ddr997/ZgrzewanieCNC/Repetier-Host/Slic3r/var/Slic3r.png

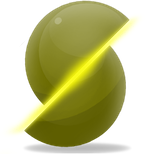
Repetier-Host/Slic3r/var/Slic3r.png
