ddr997/ZgrzewanieCNC/Repetier-Host/Slic3rPE/resources/localization/list.txt

src/slic3r/GUI/AboutDialog.cpp
src/slic3r/GUI/BackgroundSlicingProcess.cpp
src/slic3r/GUI/BedShapeDialog.cpp
src/slic3r/GUI/BedShapeDialog.hpp
src/slic3r/GUI/BonjourDialog.cpp
src/slic3r/GUI/ButtonsDescription.cpp
src/slic3r/GUI/ConfigSnapshotDialog.cpp
src/slic3r/GUI/ConfigWizard.cpp
src/slic3r/GUI/Field.cpp
src/slic3r/GUI/FirmwareDialog.cpp
src/slic3r/GUI/GLCanvas3D.cpp
src/slic3r/GUI/Gizmos/GLGizmoCut.cpp
src/slic3r/GUI/Gizmos/GLGizmoFlatten.cpp
src/slic3r/GUI/Gizmos/GLGizmoMove.cpp
src/slic3r/GUI/Gizmos/GLGizmoRotate.cpp
src/slic3r/GUI/Gizmos/GLGizmoScale.cpp
src/slic3r/GUI/Gizmos/GLGizmoSlaSupports.cpp
src/slic3r/GUI/GUI.cpp
src/slic3r/GUI/GUI_App.cpp
src/slic3r/GUI/GUI_ObjectList.cpp
src/slic3r/GUI/GUI_ObjectManipulation.cpp
src/slic3r/GUI/GUI_ObjectSettings.cpp
src/slic3r/GUI/GUI_Preview.cpp
src/slic3r/GUI/KBShortcutsDialog.cpp
src/slic3r/GUI/MainFrame.cpp
src/slic3r/GUI/MsgDialog.cpp
src/slic3r/GUI/Plater.cpp
src/slic3r/GUI/Preferences.cpp
src/slic3r/GUI/Preset.cpp
src/slic3r/GUI/PresetBundle.cpp
src/slic3r/GUI/PresetHints.cpp
src/slic3r/GUI/PrintHostDialogs.cpp
src/slic3r/GUI/ProgressStatusBar.cpp
src/slic3r/GUI/RammingChart.cpp
src/slic3r/GUI/SysInfoDialog.cpp
src/slic3r/GUI/Tab.cpp
src/slic3r/GUI/Tab.hpp
src/slic3r/GUI/UpdateDialogs.cpp
src/slic3r/GUI/WipeTowerDialog.cpp
src/slic3r/GUI/wxExtensions.cpp
src/slic3r/Utils/Duet.cpp
src/slic3r/Utils/OctoPrint.cpp
src/slic3r/Utils/PresetUpdater.cpp
src/slic3r/Utils/FixModelByWin10.cpp
src/libslic3r/Zipper.cpp
src/libslic3r/SLA/SLASupportTree.cpp
src/libslic3r/Print.cpp
src/libslic3r/SLAPrint.cpp
src/libslic3r/PrintBase.cpp
src/libslic3r/PrintConfig.cpp
src/libslic3r/PrintObject.cpp
src/libslic3r/GCode/PreviewData.cpp
