ddr997/ZgrzewanieCNC/Repetier-Host/data/ArrowX.stl

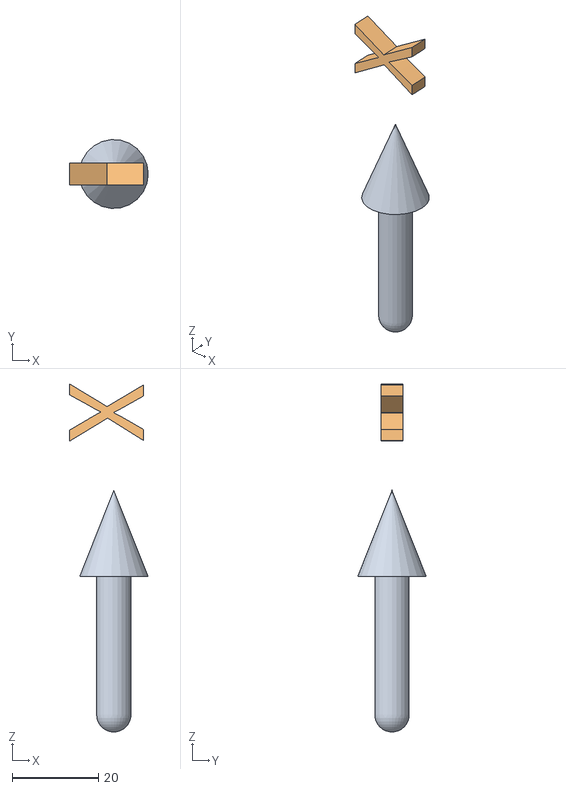
[picture p44: CAD file, 2021-02-12]
Repetier-Host/data/ArrowX.stl
18.2 x 16.0 x 80.7
Additionskörper_527
ACIS-Volumenkörper_1517
