ddr997/ZgrzewanieCNC/Repetier-Host/data/models/DemoPrinter_2.stl

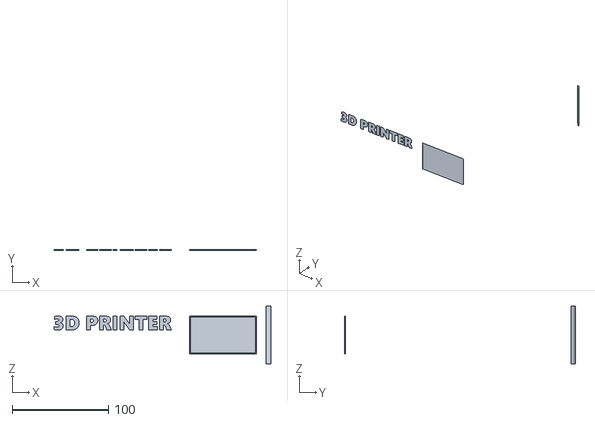
[picture p45: CAD file, 2021-02-12]
Repetier-Host/data/models/DemoPrinter_2.stl
226.0 x 241.0 x 60.0
