ddr997/ZgrzewanieCNC/Repetier-Host/Slic3rPE/resources/models/mk2_bed.stl

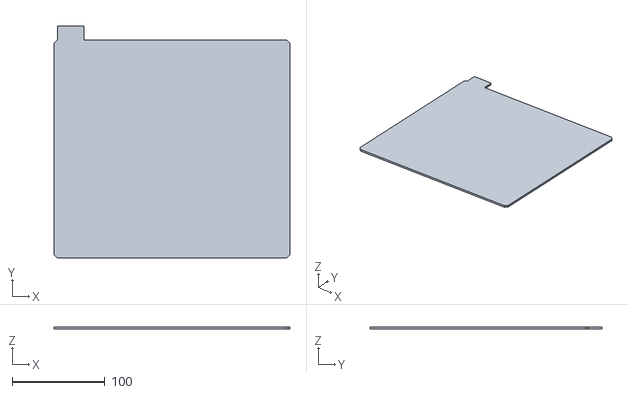
[picture p46: CAD file, 2021-02-12]
Repetier-Host/Slic3rPE/resources/models/mk2_bed.stl
254.0 x 250.0 x 2.50
