ddr997/ZgrzewanieCNC/siłownik_2membrany_plaski.stl

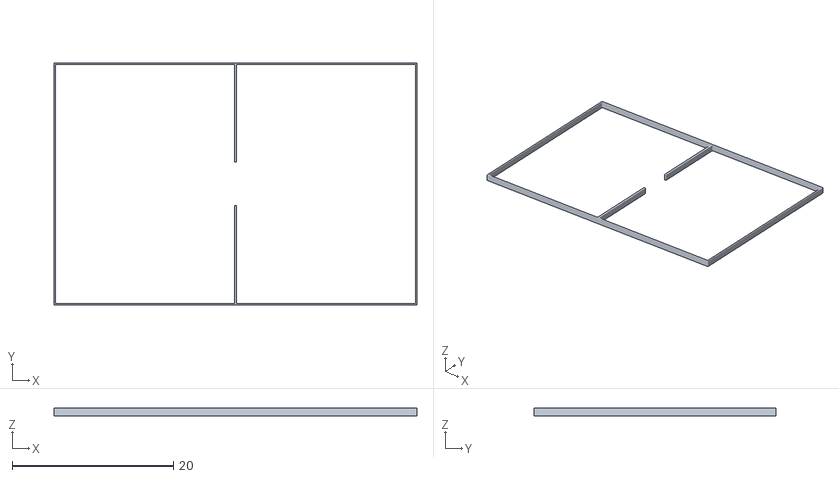
[picture p47: CAD file, 2021-02-12]
siłownik_2membrany_plaski.stl
45.0 x 30.0 x 1.00
