ddr997/ZgrzewanieCNC/Repetier-Host/data/ArrowY.stl

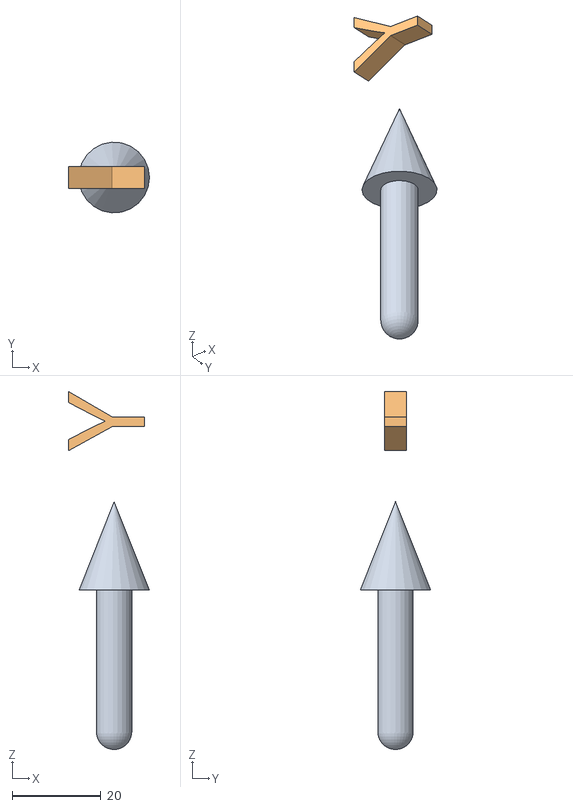
[picture p48: CAD file, 2021-02-12]
Repetier-Host/data/ArrowY.stl
18.3 x 16.0 x 80.9
Additionskörper_527
ACIS-Volumenkörper_1696
