ddr997/ZgrzewanieCNC/Repetier-Host/data/models/tablet.amf

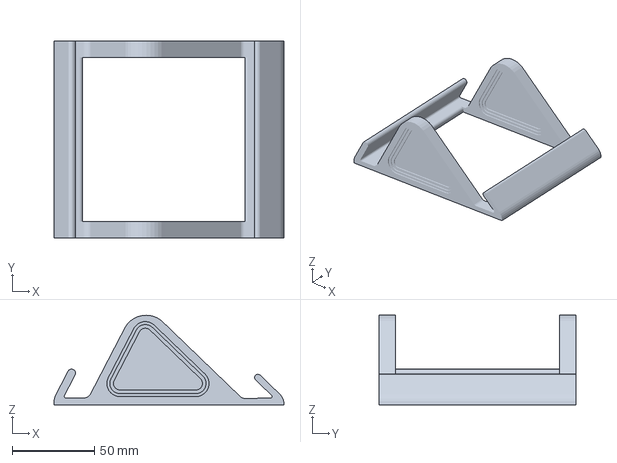
[picture p49: CAD file, 2021-02-12]
Repetier-Host/data/models/tablet.amf
140.0 x 120.0 x 54.5 mm
