ddr997/ZgrzewanieCNC/Repetier-Host/Slic3rPE/resources/models/sl1_bed.stl

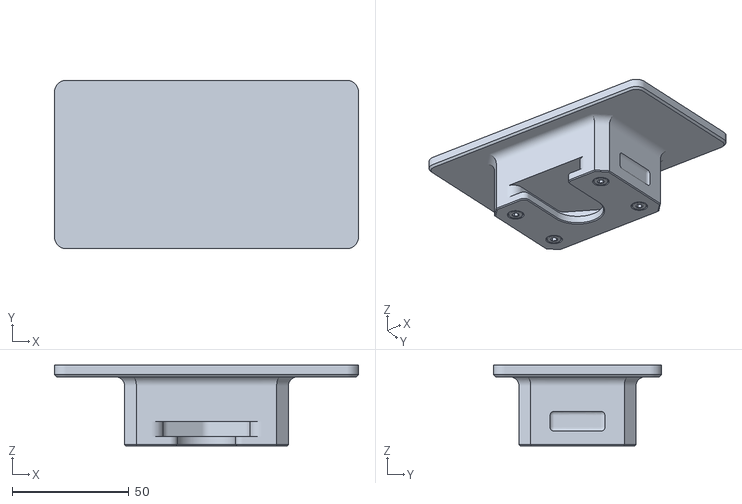
[picture p50: CAD file, 2021-02-12]
Repetier-Host/Slic3rPE/resources/models/sl1_bed.stl
130.0 x 72.0 x 34.5
