ddr997/ZgrzewanieCNC/Wentyl.stl

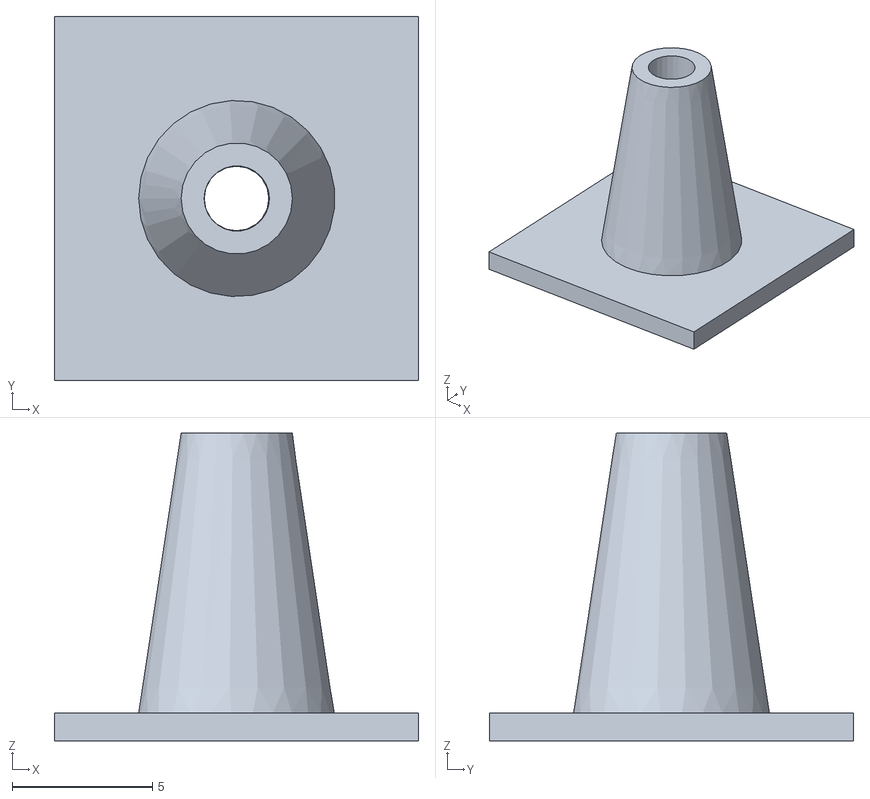
[picture p51: CAD file, 2021-02-12]
Wentyl.stl
13.0 x 13.0 x 11.0
