ddr997/ZgrzewanieCNC/Repetier-Host/data/ArrowZ.stl

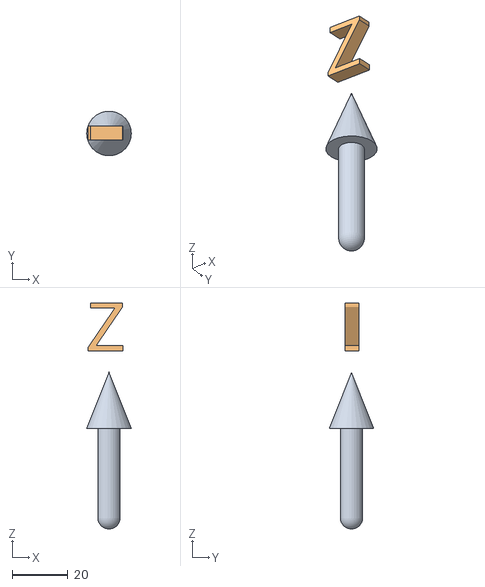
[picture p52: CAD file, 2021-02-12]
Repetier-Host/data/ArrowZ.stl
16.0 x 15.9 x 80.9
Additionskörper_527
ACIS-Volumenkörper_1836
