ddr997/ZgrzewanieCNC/Repetier-Host/data/models/DemoPrinter_1.stl

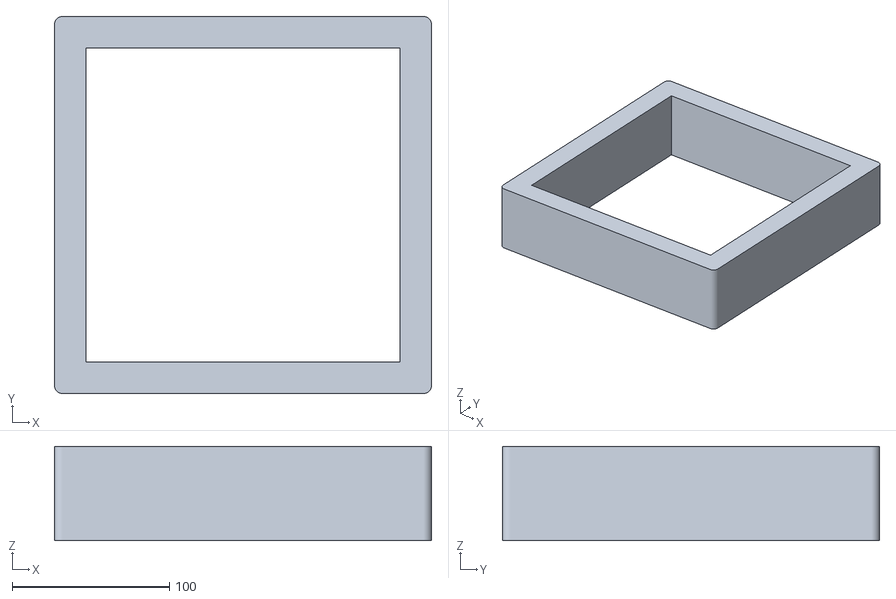
[picture p53: CAD file, 2021-02-12]
Repetier-Host/data/models/DemoPrinter_1.stl
240.0 x 240.0 x 60.0
