ddr997/ZgrzewanieCNC/Repetier-Host/Slic3rPE/resources/models/mk3_bed.stl

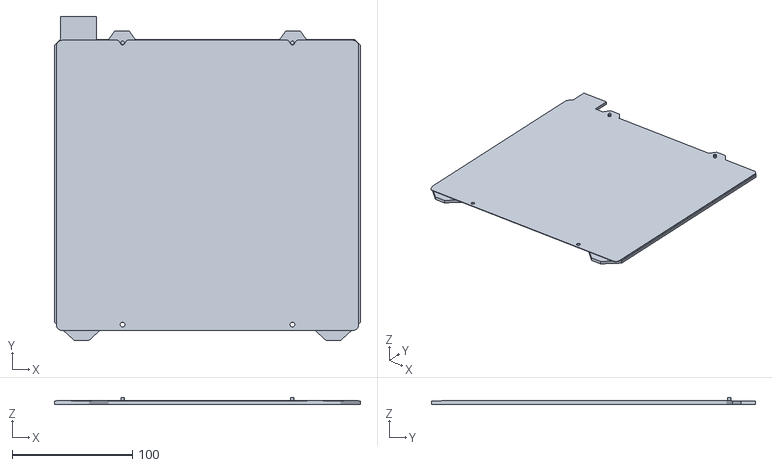
[picture p54: CAD file, 2021-02-12]
Repetier-Host/Slic3rPE/resources/models/mk3_bed.stl
254.0 x 269.0 x 6.00
