ddr997/ZgrzewanieCNC/silownik_3membrany_plaski.stl

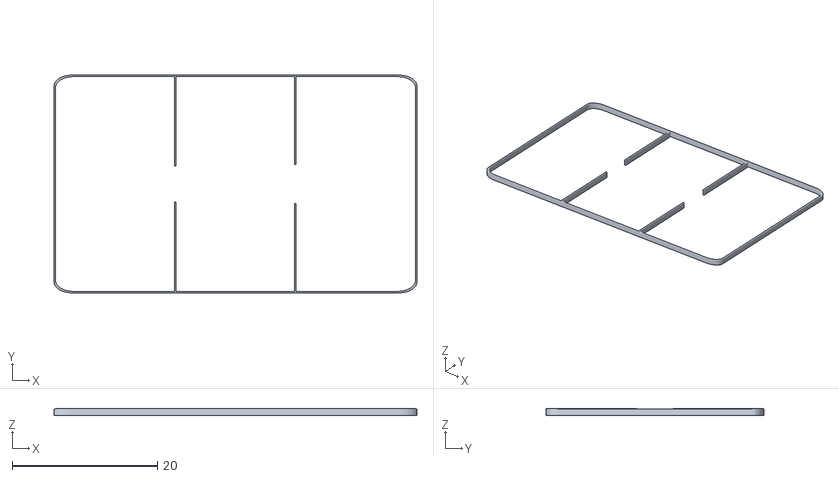
[picture p55: CAD file, 2021-02-12]
silownik_3membrany_plaski.stl
50.0 x 30.0 x 1
