ddr997/ZgrzewanieCNC/Mocowanie.stl

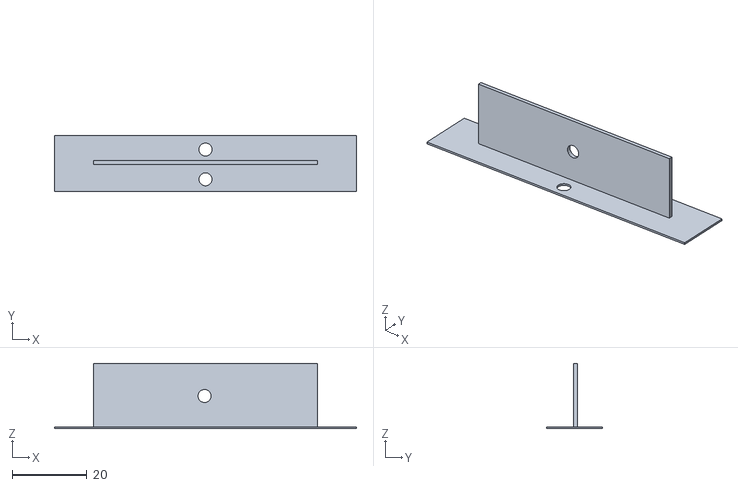
[picture p56: CAD file, 2021-02-12]
Mocowanie.stl
81.0 x 15.0 x 17.5
