ddr997/ZgrzewanieCNC/Repetier-Host/data/empty.stl

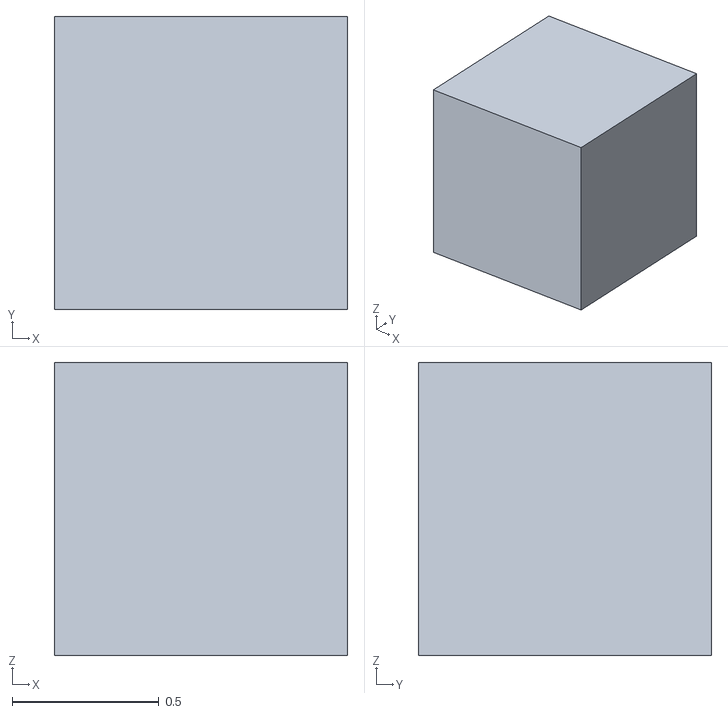
[picture p57: CAD file, 2021-02-12]
Repetier-Host/data/empty.stl
1.00 x 1.00 x 1.00
