ddr997/ZgrzewanieCNC/Repetier-Host/Slic3rPE/resources/profiles/PrusaResearch.ini

# Print profiles for the Prusa Research printers.

[vendor]
# Vendor name will be shown by the Config Wizard.
name = Prusa Research
# Configuration version of this file. Config file will only be installed, if the config_version differs.
# This means, the server may force the Slic3r configuration to be downgraded.
config_version = 0.8.0
# Where to get the updates from?
config_update_url = http://files.prusa3d.com/wp-content/uploads/repository/PrusaSlicer-settings-master/live/PrusaResearch/
changelog_url = http://files.prusa3d.com/?latest=slicer-profiles&lng=%1%

# The printer models will be shown by the Configuration Wizard in this order,
# also the first model installed & the first nozzle installed will be activated after install.
#TODO: One day we may differentiate variants of the nozzles / hot ends,
#for example by the melt zone size, or whether the nozzle is hardened.
# Printer model name will be shown by the installation wizard.

[printer_model:MK3S]
name = Original Prusa i3 MK3S
variants = 0.4; 0.25; 0.6
technology = FFF
family = MK3

[printer_model:MK3]
name = Original Prusa i3 MK3
variants = 0.4; 0.25; 0.6
technology = FFF
family = MK3

[printer_model:MK3SMMU2S]
name = Original Prusa i3 MK3S MMU2S
variants = 0.4; 0.25; 0.6
technology = FFF
family = MK3

[printer_model:MK3MMU2]
name = Original Prusa i3 MK3 MMU2
variants = 0.4; 0.25; 0.6
technology = FFF
family = MK3

[printer_model:MK2.5S]
name = Original Prusa i3 MK2.5S
variants = 0.4; 0.25; 0.6
technology = FFF
family = MK2.5

[printer_model:MK2.5]
name = Original Prusa i3 MK2.5
variants = 0.4; 0.25; 0.6
technology = FFF
family = MK2.5

[printer_model:MK2.5SMMU2S]
name = Original Prusa i3 MK2.5S MMU2S
variants = 0.4; 0.25; 0.6
technology = FFF
family = MK2.5

[printer_model:MK2.5MMU2]
name = Original Prusa i3 MK2.5 MMU2
variants = 0.4; 0.25; 0.6
technology = FFF
family = MK2.5

[printer_model:MK2S]
name = Original Prusa i3 MK2S
variants = 0.4; 0.25; 0.6
technology = FFF
family = MK2

[printer_model:MK2SMM]
name = Original Prusa i3 MK2S MMU1
variants = 0.4; 0.6
technology = FFF
family = MK2

[printer_model:SL1]
name = Original Prusa SL1
variants = default
technology = SLA
family = SL1

# All presets starting with asterisk, for example *common*, are intermediate and they will
# not make it into the user interface.

# Common print preset, mostly derived from MK2 single material with a 0.4mm nozzle.
# All other print presets will derive from the *common* print preset.
[print:*common*]
avoid_crossing_perimeters = 0
bridge_acceleration = 1000
bridge_angle = 0
bridge_flow_ratio = 0.8
bridge_speed = 20
brim_width = 0
clip_multipart_objects = 1
compatible_printers = 
complete_objects = 0
default_acceleration = 1000
dont_support_bridges = 1
elefant_foot_compensation = 0
ensure_vertical_shell_thickness = 1
external_fill_pattern = rectilinear
external_perimeters_first = 0
external_perimeter_extrusion_width = 0.45
extra_perimeters = 0
extruder_clearance_height = 20
extruder_clearance_radius = 20
extrusion_width = 0.45
fill_angle = 45
fill_density = 20%
fill_pattern = cubic
first_layer_acceleration = 1000
first_layer_extrusion_width = 0.42
first_layer_height = 0.2
first_layer_speed = 20
gap_fill_speed = 40
gcode_comments = 0
infill_every_layers = 1
infill_extruder = 1
infill_extrusion_width = 0.45
infill_first = 0
infill_only_where_needed = 0
infill_overlap = 25%
interface_shells = 0
max_print_speed = 100
max_volumetric_extrusion_rate_slope_negative = 0
max_volumetric_extrusion_rate_slope_positive = 0
max_volumetric_speed = 0
min_skirt_length = 4
notes = 
overhangs = 0
only_retract_when_crossing_perimeters = 0
ooze_prevention = 0
output_filename_format = {input_filename_base}_{layer_height}mm_{filament_type[0]}_{printer_model}.gcode
perimeters = 2
perimeter_extruder = 1
perimeter_extrusion_width = 0.45
post_process = 
print_settings_id = 
raft_layers = 0
resolution = 0
seam_position = nearest
single_extruder_multi_material_priming = 1
skirts = 1
skirt_distance = 2
skirt_height = 3
small_perimeter_speed = 25
solid_infill_below_area = 0
solid_infill_every_layers = 0
solid_infill_extruder = 1
solid_infill_extrusion_width = 0.45
spiral_vase = 0
standby_temperature_delta = -5
support_material = 0
support_material_extruder = 0
support_material_extrusion_width = 0.35
support_material_interface_extruder = 0
support_material_angle = 0
support_material_buildplate_only = 0
support_material_enforce_layers = 0
support_material_contact_distance = 0.1
support_material_interface_contact_loops = 0
support_material_interface_layers = 2
support_material_interface_spacing = 0.2
support_material_interface_speed = 100%
support_material_pattern = rectilinear
support_material_spacing = 2
support_material_speed = 50
support_material_synchronize_layers = 0
support_material_threshold = 55
support_material_with_sheath = 0
support_material_xy_spacing = 50%
thin_walls = 0
top_infill_extrusion_width = 0.45
top_solid_infill_speed = 40
travel_speed = 180
wipe_tower = 1
wipe_tower_bridging = 10
wipe_tower_rotation_angle = 0
wipe_tower_width = 60
wipe_tower_x = 170
wipe_tower_y = 140
xy_size_compensation = 0

[print:*MK3*]
fill_pattern = grid
single_extruder_multi_material_priming = 0
travel_speed = 180
wipe_tower_x = 170
wipe_tower_y = 125

[print:*MK306*]
fill_pattern = gyroid
fill_density = 15%
single_extruder_multi_material_priming = 0
travel_speed = 180
wipe_tower_x = 170
wipe_tower_y = 125

# Print parameters common to a 0.25mm diameter nozzle.
[print:*0.25nozzle*]
external_perimeter_extrusion_width = 0.25
extrusion_width = 0.25
first_layer_extrusion_width = 0.25
infill_extrusion_width = 0.25
perimeter_extrusion_width = 0.25
solid_infill_extrusion_width = 0.25
top_infill_extrusion_width = 0.25
support_material_extrusion_width = 0.2
support_material_interface_layers = 0
support_material_interface_spacing = 0.15
support_material_spacing = 1
support_material_xy_spacing = 150%

[print:*0.25nozzleMK3*]
external_perimeter_extrusion_width = 0.25
extrusion_width = 0.25
first_layer_extrusion_width = 0.35
infill_extrusion_width = 0.25
perimeter_extrusion_width = 0.25
solid_infill_extrusion_width = 0.25
top_infill_extrusion_width = 0.25
support_material_extrusion_width = 0.2
support_material_interface_layers = 0
support_material_interface_spacing = 0.15
support_material_spacing = 1
support_material_xy_spacing = 150%
perimeter_speed = 30
external_perimeter_speed = 20
small_perimeter_speed = 20
infill_speed = 45
solid_infill_speed = 45
top_solid_infill_speed = 30
support_material_speed = 40
bridge_speed = 20
gap_fill_speed = 30
perimeter_acceleration = 500
infill_acceleration = 1000
bridge_acceleration = 500
first_layer_acceleration = 500
default_acceleration = 1000
max_print_speed = 80
perimeters = 3
fill_pattern = grid
fill_density = 20%

# Print parameters common to a 0.6mm diameter nozzle.
[print:*0.6nozzle*]
external_perimeter_extrusion_width = 0.61
extrusion_width = 0.67
first_layer_extrusion_width = 0.65
infill_extrusion_width = 0.7
perimeter_extrusion_width = 0.65
solid_infill_extrusion_width = 0.65
top_infill_extrusion_width = 0.6
support_material_extrusion_width = 0.55

[print:*0.6nozzleMK3*]
external_perimeter_extrusion_width = 0.65
extrusion_width = 0.65
first_layer_extrusion_width = 0.65
infill_extrusion_width = 0.7
perimeter_extrusion_width = 0.65
solid_infill_extrusion_width = 0.7
top_infill_extrusion_width = 0.6
support_material_extrusion_width = 0.55
bridge_flow_ratio = 0.95
bridge_speed = 25

[print:*soluble_support*]
overhangs = 1
skirts = 0
support_material = 1
support_material_contact_distance = 0
support_material_extruder = 4
support_material_extrusion_width = 0.45
support_material_interface_extruder = 4
support_material_interface_spacing = 0.1
support_material_synchronize_layers = 1
support_material_threshold = 80
support_material_with_sheath = 1
wipe_tower_bridging = 8

# XXXXXXXXXXXXXXXXXXXX
# XXX--- 0.05mm ---XXX
# XXXXXXXXXXXXXXXXXXXX

[print:*0.05mm*]
inherits = *common*
bottom_solid_layers = 10
bridge_acceleration = 300
bridge_flow_ratio = 0.7
default_acceleration = 500
external_perimeter_speed = 20
fill_density = 20%
first_layer_acceleration = 500
gap_fill_speed = 20
infill_acceleration = 800
infill_speed = 30
max_print_speed = 80
small_perimeter_speed = 20
solid_infill_speed = 30
support_material_extrusion_width = 0.3
support_material_spacing = 1.5
layer_height = 0.05
perimeter_acceleration = 300
perimeter_speed = 30
perimeters = 3
support_material_speed = 30
top_solid_infill_speed = 20
top_solid_layers = 15

[print:0.05mm ULTRADETAIL]
inherits = *0.05mm*
compatible_printers_condition = printer_notes=~/.*PRINTER_VENDOR_PRUSA3D.*/ and printer_notes=~/.*PRINTER_MODEL_MK2.*/ and nozzle_diameter[0]==0.4 and num_extruders==1
infill_extrusion_width = 0.5

# MK3 #
[print:0.05mm ULTRADETAIL MK3]
inherits = *0.05mm*; *MK3*
fill_pattern = gyroid
fill_density = 15%
compatible_printers_condition = printer_notes=~/.*PRINTER_VENDOR_PRUSA3D.*/ and printer_notes=~/.*PRINTER_MODEL_MK3.*/  and nozzle_diameter[0]==0.4 and ! single_extruder_multi_material
top_infill_extrusion_width = 0.4

# MK2 #
[print:0.05mm ULTRADETAIL 0.25 nozzle]
inherits = *0.05mm*; *0.25nozzle*
compatible_printers_condition = printer_notes=~/.*PRINTER_VENDOR_PRUSA3D.*/ and printer_notes=~/.*PRINTER_MODEL_MK2.*/ and nozzle_diameter[0]==0.25 and num_extruders==1
fill_density = 20%
infill_speed = 20
max_print_speed = 100
perimeter_speed = 20
small_perimeter_speed = 15
solid_infill_speed = 20
support_material_speed = 20

# MK3 #
[print:0.05mm ULTRADETAIL 0.25 nozzle MK3]
inherits = *0.05mm*; *0.25nozzle*; *MK3*
compatible_printers_condition = printer_notes=~/.*PRINTER_VENDOR_PRUSA3D.*/ and printer_notes=~/.*PRINTER_MODEL_MK3.*/ and nozzle_diameter[0]==0.25 and num_extruders==1
fill_pattern = grid
fill_density = 20%
first_layer_extrusion_width = 0.35

# XXXXXXXXXXXXXXXXXXXX
# XXX--- 0.07mm ---XXX
# XXXXXXXXXXXXXXXXXXXX

[print:*0.07mm*]
inherits = *common*
bottom_solid_layers = 8
bridge_acceleration = 300
bridge_flow_ratio = 0.7
bridge_speed = 20
default_acceleration = 500
external_perimeter_speed = 20
fill_density = 15%
first_layer_acceleration = 500
gap_fill_speed = 20
infill_acceleration = 800
infill_speed = 40
max_print_speed = 80
small_perimeter_speed = 20
solid_infill_speed = 40
support_material_extrusion_width = 0.3
support_material_spacing = 1.5
layer_height = 0.07
perimeter_acceleration = 300
perimeter_speed = 30
perimeters = 3
support_material_speed = 40
top_solid_infill_speed = 30
top_solid_layers = 11

# MK3 #
[print:0.07mm ULTRADETAIL MK3]
inherits = *0.07mm*; *MK3*
fill_pattern = gyroid
compatible_printers_condition = printer_notes=~/.*PRINTER_VENDOR_PRUSA3D.*/ and printer_notes=~/.*PRINTER_MODEL_MK3.*/  and nozzle_diameter[0]==0.4 and ! single_extruder_multi_material
top_infill_extrusion_width = 0.4

[print:0.07mm ULTRADETAIL 0.25 nozzle MK3]
inherits = *0.07mm*; *0.25nozzle*; *MK3*
compatible_printers_condition = printer_notes=~/.*PRINTER_VENDOR_PRUSA3D.*/ and printer_notes=~/.*PRINTER_MODEL_MK3.*/ and nozzle_diameter[0]==0.25 and num_extruders==1
infill_speed = 30
solid_infill_speed = 30
support_material_speed = 30
top_solid_infill_speed = 20
fill_pattern = grid
fill_density = 20%
first_layer_extrusion_width = 0.35

# XXXXXXXXXXXXXXXXXXXX
# XXX--- 0.10mm ---XXX
# XXXXXXXXXXXXXXXXXXXX

# MK2 #
[print:*0.10mm*]
inherits = *common*
bottom_solid_layers = 7
bridge_flow_ratio = 0.7
compatible_printers_condition = printer_notes=~/.*PRINTER_VENDOR_PRUSA3D.*/ and printer_notes=~/.*PRINTER_MODEL_MK2.*/ and nozzle_diameter[0]==0.4 and num_extruders==1
layer_height = 0.1
perimeter_acceleration = 800
top_solid_layers = 9

# MK2 #
[print:0.10mm DETAIL]
inherits = *0.10mm*
compatible_printers_condition = printer_notes=~/.*PRINTER_VENDOR_PRUSA3D.*/ and printer_notes=~/.*PRINTER_MODEL_MK2.*/ and nozzle_diameter[0]==0.4 and num_extruders==1
external_perimeter_speed = 40
infill_acceleration = 2000
infill_speed = 60
perimeter_speed = 50
solid_infill_speed = 50

# MK3 #
[print:0.10mm DETAIL MK3]
inherits = *0.10mm*; *MK3*
bridge_speed = 30
compatible_printers_condition = printer_notes=~/.*PRINTER_VENDOR_PRUSA3D.*/ and printer_notes=~/.*PRINTER_MODEL_MK3.*/ and nozzle_diameter[0]==0.4 and ! single_extruder_multi_material
external_perimeter_speed = 25
infill_acceleration = 1250
infill_speed = 80
max_print_speed = 200
perimeter_speed = 45
solid_infill_speed = 80
top_infill_extrusion_width = 0.4
top_solid_infill_speed = 40
fill_pattern = gyroid
fill_density = 15%

# MK2 #
[print:0.10mm DETAIL 0.25 nozzle]
inherits = *0.10mm*; *0.25nozzle*
bridge_acceleration = 600
compatible_printers_condition = printer_notes=~/.*PRINTER_VENDOR_PRUSA3D.*/ and printer_notes=~/.*PRINTER_MODEL_MK2.*/ and nozzle_diameter[0]==0.25
external_perimeter_speed = 20
infill_acceleration = 1600
infill_speed = 40
perimeter_acceleration = 600
perimeter_speed = 25
small_perimeter_speed = 15
solid_infill_speed = 40
top_solid_infill_speed = 30

# MK3 #
[print:0.10mm DETAIL 0.25 nozzle MK3]
inherits = *0.10mm*; *0.25nozzleMK3*; *MK3*
compatible_printers_condition = printer_notes=~/.*PRINTER_VENDOR_PRUSA3D.*/ and printer_notes=~/.*PRINTER_MODEL_MK3.*/ and nozzle_diameter[0]==0.25
fill_pattern = grid
fill_density = 20%

# XXXXXXXXXXXXXXXXXXXX
# XXX--- 0.15mm ---XXX
# XXXXXXXXXXXXXXXXXXXX

[print:*0.15mm*]
inherits = *common*
bottom_solid_layers = 5
external_perimeter_speed = 40
infill_acceleration = 2000
infill_speed = 60
layer_height = 0.15
perimeter_acceleration = 800
perimeter_speed = 50
solid_infill_speed = 50
top_infill_extrusion_width = 0.4
top_solid_layers = 7

# MK2 #
[print:0.15mm 100mms Linear Advance]
inherits = *0.15mm*
bridge_flow_ratio = 0.95
compatible_printers_condition = printer_notes=~/.*PRINTER_VENDOR_PRUSA3D.*/ and printer_notes=~/.*PRINTER_MODEL_MK2[^\.].*/ and nozzle_diameter[0]==0.4
external_perimeter_speed = 50
infill_speed = 100
max_print_speed = 150
perimeter_speed = 60
small_perimeter_speed = 30
solid_infill_speed = 100
support_material_speed = 60
top_solid_infill_speed = 70

# MK2 #
[print:0.15mm OPTIMAL]
inherits = *0.15mm*
compatible_printers_condition = printer_notes=~/.*PRINTER_VENDOR_PRUSA3D.*/ and printer_notes=~/.*PRINTER_MODEL_MK2[^\.].*/ and nozzle_diameter[0]==0.4
top_infill_extrusion_width = 0.45

# MK2 #
[print:0.15mm OPTIMAL 0.25 nozzle]
inherits = *0.15mm*; *0.25nozzle*
bridge_acceleration = 600
bridge_flow_ratio = 0.7
compatible_printers_condition = printer_notes=~/.*PRINTER_VENDOR_PRUSA3D.*/ and printer_notes=~/.*PRINTER_MODEL_MK2.*/ and nozzle_diameter[0]==0.25
external_perimeter_speed = 20
infill_acceleration = 1600
infill_speed = 40
perimeter_acceleration = 600
perimeter_speed = 25
small_perimeter_speed = 15
solid_infill_speed = 40
top_solid_infill_speed = 30

# MK2 #
[print:0.15mm OPTIMAL 0.6 nozzle]
inherits = *0.15mm*; *0.6nozzle*
compatible_printers_condition = printer_notes=~/.*PRINTER_VENDOR_PRUSA3D.*/ and printer_notes=~/.*PRINTER_MODEL_MK2.*/ and nozzle_diameter[0]==0.6

# MK3 #
[print:0.15mm QUALITY MK3]
inherits = *0.15mm*; *MK3*
bridge_speed = 30
compatible_printers_condition = printer_notes=~/.*PRINTER_VENDOR_PRUSA3D.*/ and printer_notes=~/.*PRINTER_MODEL_MK3.*/ and nozzle_diameter[0]==0.4
external_perimeter_speed = 25
infill_acceleration = 1250
infill_speed = 80
max_print_speed = 200
perimeter_speed = 45
solid_infill_speed = 80
top_solid_infill_speed = 40
fill_pattern = gyroid
fill_density = 15%

[print:0.15mm SPEED MK3]
inherits = *0.15mm*; *MK3*
bridge_speed = 30
compatible_printers_condition = printer_notes=~/.*PRINTER_VENDOR_PRUSA3D.*/ and printer_notes=~/.*PRINTER_MODEL_MK3.*/ and nozzle_diameter[0]==0.4
external_perimeter_speed = 35
infill_acceleration = 1250
infill_speed = 200
max_print_speed = 200
perimeter_speed = 60
solid_infill_speed = 200
top_solid_infill_speed = 50

# MK3 MMU #
[print:0.15mm SOLUBLE FULL MK3]
inherits = 0.15mm SPEED MK3; *soluble_support*
compatible_printers_condition = printer_notes=~/.*PRINTER_VENDOR_PRUSA3D.*/ and printer_notes=~/.*PRINTER_MODEL_MK3.*/ and nozzle_diameter[0]==0.4 and num_extruders>1
notes = Set your soluble extruder in Multiple Extruders > Support material/raft/skirt extruder &  Support material/raft interface extruder
support_material_extruder = 5
support_material_interface_extruder = 5
perimeter_speed = 40
solid_infill_speed = 40
top_infill_extrusion_width = 0.45
top_solid_infill_speed = 30

# MK3 MMU #
[print:0.15mm SOLUBLE INTERFACE MK3]
inherits = 0.15mm SOLUBLE FULL MK3
notes = Set your soluble extruder in Multiple Extruders >  Support material/raft interface extruder
support_material_extruder = 0
support_material_interface_layers = 3
support_material_with_sheath = 0

# MK2 MMU #
[print:0.15mm OPTIMAL SOLUBLE FULL]
inherits = *0.15mm*; *soluble_support*
compatible_printers_condition = printer_notes=~/.*PRINTER_VENDOR_PRUSA3D.*/ and printer_notes=~/.*PRINTER_MODEL_MK2[^\.].*/ and nozzle_diameter[0]==0.4 and num_extruders>1
external_perimeter_speed = 25
notes = Set your soluble extruder in Multiple Extruders > Support material/raft/skirt extruder &  Support material/raft interface extruder
perimeter_speed = 40
solid_infill_speed = 40
top_infill_extrusion_width = 0.45
top_solid_infill_speed = 30

# MK2 MMU #
[print:0.15mm OPTIMAL SOLUBLE INTERFACE]
inherits = 0.15mm OPTIMAL SOLUBLE FULL
notes = Set your soluble extruder in Multiple Extruders >  Support material/raft interface extruder
support_material_extruder = 0
support_material_interface_layers = 3
support_material_with_sheath = 0
support_material_xy_spacing = 80%

# MK3 #
[print:0.15mm QUALITY 0.25 nozzle MK3]
inherits = *0.15mm*; *0.25nozzleMK3*; *MK3*
compatible_printers_condition = printer_notes=~/.*PRINTER_VENDOR_PRUSA3D.*/ and printer_notes=~/.*PRINTER_MODEL_MK3.*/ and nozzle_diameter[0]==0.25
fill_pattern = grid
fill_density = 20%

# MK3 #
[print:0.15mm DETAIL 0.6 nozzle MK3]
inherits = *0.15mm*; *0.6nozzleMK3*; *MK306*
compatible_printers_condition = printer_notes=~/.*PRINTER_VENDOR_PRUSA3D.*/ and printer_notes=~/.*PRINTER_MODEL_MK3.*/ and nozzle_diameter[0]==0.6
external_perimeter_speed = 35
infill_acceleration = 1250
infill_speed = 70
max_print_speed = 100
perimeter_speed = 45
solid_infill_speed = 70
top_solid_infill_speed = 45

# XXXXXXXXXXXXXXXXXXXX
# XXX--- 0.20mm ---XXX
# XXXXXXXXXXXXXXXXXXXX

[print:*0.20mm*]
inherits = *common*
bottom_solid_layers = 4
bridge_flow_ratio = 0.95
external_perimeter_speed = 40
infill_acceleration = 2000
infill_speed = 60
layer_height = 0.2
perimeter_acceleration = 800
perimeter_speed = 50
solid_infill_speed = 50
top_infill_extrusion_width = 0.4
top_solid_layers = 5

# MK2 #
[print:0.20mm 100mms Linear Advance]
inherits = *0.20mm*
compatible_printers_condition = printer_notes=~/.*PRINTER_VENDOR_PRUSA3D.*/ and printer_notes=~/.*PRINTER_MODEL_MK2[^\.].*/ and nozzle_diameter[0]==0.4
external_perimeter_speed = 50
infill_speed = 100
max_print_speed = 150
perimeter_speed = 60
small_perimeter_speed = 30
solid_infill_speed = 100
support_material_speed = 60
top_solid_infill_speed = 70

# MK3 #
[print:0.20mm QUALITY MK3]
inherits = *0.20mm*; *MK3*
bridge_speed = 30
compatible_printers_condition = printer_notes=~/.*PRINTER_VENDOR_PRUSA3D.*/ and printer_notes=~/.*PRINTER_MODEL_MK3.*/ and nozzle_diameter[0]==0.4
external_perimeter_speed = 25
infill_acceleration = 1250
infill_speed = 80
max_print_speed = 200
perimeter_speed = 45
solid_infill_speed = 80
top_solid_infill_speed = 40
fill_pattern = gyroid
fill_density = 15%

[print:0.20mm SPEED MK3]
inherits = *0.20mm*; *MK3*
bridge_speed = 30
compatible_printers_condition = printer_notes=~/.*PRINTER_VENDOR_PRUSA3D.*/ and printer_notes=~/.*PRINTER_MODEL_MK3.*/ and nozzle_diameter[0]==0.4
external_perimeter_speed = 35
infill_acceleration = 1250
infill_speed = 200
max_print_speed = 200
perimeter_speed = 60
solid_infill_speed = 200
top_solid_infill_speed = 50

# MK3 MMU #
[print:0.20mm SOLUBLE FULL MK3]
inherits = 0.20mm SPEED MK3; *soluble_support*
compatible_printers_condition = printer_notes=~/.*PRINTER_VENDOR_PRUSA3D.*/ and printer_notes=~/.*PRINTER_MODEL_MK3.*/ and nozzle_diameter[0]==0.4 and num_extruders>1
notes = Set your soluble extruder in Multiple Extruders > Support material/raft/skirt extruder &  Support material/raft interface extruder
support_material_extruder = 5
support_material_interface_extruder = 5
perimeter_speed = 40
solid_infill_speed = 40
top_infill_extrusion_width = 0.45
top_solid_infill_speed = 30

# MK3 MMU #
[print:0.20mm SOLUBLE INTERFACE MK3]
inherits = 0.20mm SOLUBLE FULL MK3
notes = Set your soluble extruder in Multiple Extruders >  Support material/raft interface extruder
support_material_extruder = 0
support_material_interface_layers = 3
support_material_with_sheath = 0

# MK2 #
[print:0.20mm NORMAL]
inherits = *0.20mm*
compatible_printers_condition = printer_notes=~/.*PRINTER_VENDOR_PRUSA3D.*/ and printer_notes=~/.*PRINTER_MODEL_MK2[^\.].*/ and nozzle_diameter[0]==0.4

# MK2 #
[print:0.20mm NORMAL 0.6 nozzle]
inherits = *0.20mm*; *0.6nozzle*
compatible_printers_condition = printer_notes=~/.*PRINTER_VENDOR_PRUSA3D.*/ and printer_notes=~/.*PRINTER_MODEL_MK2.*/ and nozzle_diameter[0]==0.6

# MK2 MMU #
[print:0.20mm NORMAL SOLUBLE FULL]
inherits = *0.20mm*; *soluble_support*
compatible_printers_condition = printer_notes=~/.*PRINTER_VENDOR_PRUSA3D.*/ and printer_notes=~/.*PRINTER_MODEL_MK2[^\.].*/ and nozzle_diameter[0]==0.4 and num_extruders>1
external_perimeter_speed = 30
notes = Set your soluble extruder in Multiple Extruders > Support material/raft/skirt extruder &  Support material/raft interface extruder
perimeter_speed = 40
solid_infill_speed = 40
top_solid_infill_speed = 30

# MK2 MMU #
[print:0.20mm NORMAL SOLUBLE INTERFACE]
inherits = 0.20mm NORMAL SOLUBLE FULL
notes = Set your soluble extruder in Multiple Extruders >  Support material/raft interface extruder
support_material_extruder = 0
support_material_interface_layers = 3
support_material_with_sheath = 0
support_material_xy_spacing = 80%

# MK3 #
[print:0.20mm DETAIL 0.6 nozzle MK3]
inherits = *0.20mm*; *0.6nozzleMK3*; *MK306*
compatible_printers_condition = printer_notes=~/.*PRINTER_VENDOR_PRUSA3D.*/ and printer_notes=~/.*PRINTER_MODEL_MK3.*/ and nozzle_diameter[0]==0.6
external_perimeter_speed = 35
infill_acceleration = 1250
infill_speed = 70
max_print_speed = 100
perimeter_speed = 45
solid_infill_speed = 70
top_solid_infill_speed = 45

# XXXXXXXXXXXXXXXXXXXX
# XXX--- 0.30mm ---XXX
# XXXXXXXXXXXXXXXXXXXX

[print:*0.30mm*]
inherits = *common*
bottom_solid_layers = 4
bridge_flow_ratio = 0.95
external_perimeter_speed = 40
infill_acceleration = 2000
infill_speed = 60
layer_height = 0.3
perimeter_acceleration = 800
perimeter_speed = 50
solid_infill_speed = 50
top_infill_extrusion_width = 0.4
top_solid_layers = 4

[print:0.30mm QUALITY 0.6 nozzle MK3]
inherits = *0.30mm*; *0.6nozzleMK3*; *MK306*
compatible_printers_condition = printer_notes=~/.*PRINTER_VENDOR_PRUSA3D.*/ and printer_notes=~/.*PRINTER_MODEL_MK3.*/ and nozzle_diameter[0]==0.6
external_perimeter_speed = 35
infill_acceleration = 1250
infill_speed = 70
max_print_speed = 100
perimeter_speed = 45
solid_infill_speed = 70
top_solid_infill_speed = 45

[print:0.30mm DRAFT MK3]
inherits = *0.30mm*; *MK3*
bottom_solid_layers = 3
bridge_speed = 30
compatible_printers_condition = printer_notes=~/.*PRINTER_VENDOR_PRUSA3D.*/ and printer_notes=~/.*PRINTER_MODEL_MK3.*/ and nozzle_diameter[0]==0.4
external_perimeter_speed = 35
infill_acceleration = 1250
infill_speed = 85
max_print_speed = 200
perimeter_speed = 50
small_perimeter_speed = 30
solid_infill_speed = 80
top_solid_infill_speed = 40
support_material_speed = 45
external_perimeter_extrusion_width = 0.6
extrusion_width = 0.5
first_layer_extrusion_width = 0.42
infill_extrusion_width = 0.5
perimeter_extrusion_width = 0.5
solid_infill_extrusion_width = 0.5
top_infill_extrusion_width = 0.45
support_material_extrusion_width = 0.35

# XXXXXXXXXXXXXXXXXXXX
# XXX--- 0.35mm ---XXX
# XXXXXXXXXXXXXXXXXXXX

[print:*0.35mm*]
inherits = *common*
bottom_solid_layers = 3
external_perimeter_extrusion_width = 0.6
external_perimeter_speed = 40
first_layer_extrusion_width = 0.75
infill_acceleration = 2000
infill_speed = 60
layer_height = 0.35
perimeter_acceleration = 800
perimeter_extrusion_width = 0.65
perimeter_speed = 50
solid_infill_extrusion_width = 0.65
solid_infill_speed = 60
top_solid_infill_speed = 50
top_solid_layers = 4

# MK2 #
[print:0.35mm FAST]
inherits = *0.35mm*
bridge_flow_ratio = 0.95
compatible_printers_condition = printer_notes=~/.*PRINTER_VENDOR_PRUSA3D.*/ and printer_notes=~/.*PRINTER_MODEL_MK2[^\.].*/ and nozzle_diameter[0]==0.4
first_layer_extrusion_width = 0.42
perimeter_extrusion_width = 0.43
solid_infill_extrusion_width = 0.7
top_infill_extrusion_width = 0.43

# MK2 #
[print:0.35mm FAST 0.6 nozzle]
inherits = *0.35mm*; *0.6nozzle*
compatible_printers_condition = printer_notes=~/.*PRINTER_VENDOR_PRUSA3D.*/ and printer_notes=~/.*PRINTER_MODEL_MK2.*/ and nozzle_diameter[0]==0.6

# MK2 MMU #
[print:0.35mm FAST sol full 0.6 nozzle]
inherits = *0.35mm*; *0.6nozzle*; *soluble_support*
compatible_printers_condition = printer_notes=~/.*PRINTER_VENDOR_PRUSA3D.*/ and printer_notes=~/.*PRINTER_MODEL_MK2.*/ and nozzle_diameter[0]==0.6 and num_extruders>1
external_perimeter_extrusion_width = 0.6
external_perimeter_speed = 30
notes = Set your solluble extruder in Multiple Extruders >  Support material/raft interface extruder
perimeter_speed = 40
support_material_interface_layers = 3
support_material_xy_spacing = 120%
top_infill_extrusion_width = 0.57

# MK2 MMU #
[print:0.35mm FAST sol int 0.6 nozzle]
inherits = 0.35mm FAST sol full 0.6 nozzle
support_material_extruder = 0
support_material_interface_layers = 2
support_material_with_sheath = 0
support_material_xy_spacing = 150%

# MK3 #
[print:0.35mm SPEED 0.6 nozzle MK3]
inherits = *0.35mm*; *0.6nozzleMK3*; *MK306*
compatible_printers_condition = printer_notes=~/.*PRINTER_VENDOR_PRUSA3D.*/ and printer_notes=~/.*PRINTER_MODEL_MK3.*/ and nozzle_diameter[0]==0.6
external_perimeter_speed = 35
infill_acceleration = 1250
infill_speed = 70
max_print_speed = 100
perimeter_speed = 45
solid_infill_speed = 70
top_solid_infill_speed = 45
external_perimeter_extrusion_width = 0.68
perimeter_extrusion_width = 0.68

# XXXXXXXXXXXXXXXXXXXX
# XXX--- 0.40mm ---XXX
# XXXXXXXXXXXXXXXXXXXX

[print:*0.40mm*]
inherits = *common*
bottom_solid_layers = 3
external_perimeter_extrusion_width = 0.6
external_perimeter_speed = 40
first_layer_extrusion_width = 0.65
infill_acceleration = 2000
infill_speed = 60
layer_height = 0.4
perimeter_acceleration = 800
perimeter_extrusion_width = 0.65
perimeter_speed = 50
solid_infill_extrusion_width = 0.65
solid_infill_speed = 60
top_solid_infill_speed = 40
top_solid_layers = 4

# MK3 #
[print:0.40mm DRAFT 0.6 nozzle MK3]
inherits = *0.40mm*; *0.6nozzleMK3*; *MK306*
compatible_printers_condition = printer_notes=~/.*PRINTER_VENDOR_PRUSA3D.*/ and printer_notes=~/.*PRINTER_MODEL_MK3.*/ and nozzle_diameter[0]==0.6
external_perimeter_speed = 35
infill_acceleration = 1250
infill_speed = 70
max_print_speed = 100
perimeter_speed = 45
solid_infill_speed = 70
top_solid_infill_speed = 45
external_perimeter_extrusion_width = 0.7
perimeter_extrusion_width = 0.7
infill_extrusion_width = 0.72
solid_infill_extrusion_width = 0.72

# XXXXXXXXXXXXXXXXXXXXXX
# XXX----- MK2.5 ----XXX
# XXXXXXXXXXXXXXXXXXXXXX

# MK2.5 #
[print:0.15mm 100mms Linear Advance MK2.5]
inherits = 0.15mm 100mms Linear Advance
compatible_printers_condition = printer_notes=~/.*PRINTER_VENDOR_PRUSA3D.*/ and printer_notes=~/.*PRINTER_MODEL_MK2.5.*/ and nozzle_diameter[0]==0.4
single_extruder_multi_material_priming = 0

# MK2.5 #
[print:0.15mm OPTIMAL MK2.5]
inherits = 0.15mm OPTIMAL
compatible_printers_condition = printer_notes=~/.*PRINTER_VENDOR_PRUSA3D.*/ and printer_notes=~/.*PRINTER_MODEL_MK2.5.*/ and nozzle_diameter[0]==0.4
single_extruder_multi_material_priming = 0

# MK2.5 MMU2 #
[print:0.15mm OPTIMAL SOLUBLE FULL MK2.5]
inherits = 0.15mm OPTIMAL SOLUBLE FULL
support_material_extruder = 5
support_material_interface_extruder = 5
compatible_printers_condition = printer_notes=~/.*PRINTER_VENDOR_PRUSA3D.*/ and printer_notes=~/.*PRINTER_MODEL_MK2.5.*/ and nozzle_diameter[0]==0.4 and num_extruders>1

# MK2.5 MMU2 #
[print:0.15mm OPTIMAL SOLUBLE INTERFACE MK2.5]
inherits = 0.15mm OPTIMAL SOLUBLE INTERFACE
support_material_extruder = 0
support_material_interface_extruder = 5
compatible_printers_condition = printer_notes=~/.*PRINTER_VENDOR_PRUSA3D.*/ and printer_notes=~/.*PRINTER_MODEL_MK2.5.*/ and nozzle_diameter[0]==0.4 and num_extruders>1

# MK2.5 #
[print:0.20mm 100mms Linear Advance MK2.5]
inherits = 0.20mm 100mms Linear Advance
compatible_printers_condition = printer_notes=~/.*PRINTER_VENDOR_PRUSA3D.*/ and printer_notes=~/.*PRINTER_MODEL_MK2.5.*/ and nozzle_diameter[0]==0.4
single_extruder_multi_material_priming = 0

# MK2.5 #
[print:0.20mm NORMAL MK2.5]
inherits = 0.20mm NORMAL
compatible_printers_condition = printer_notes=~/.*PRINTER_VENDOR_PRUSA3D.*/ and printer_notes=~/.*PRINTER_MODEL_MK2.5.*/ and nozzle_diameter[0]==0.4
single_extruder_multi_material_priming = 0

# MK2.5 MMU2 #
[print:0.20mm NORMAL SOLUBLE FULL MK2.5]
inherits = 0.20mm NORMAL SOLUBLE FULL
support_material_extruder = 5
support_material_interface_extruder = 5
compatible_printers_condition = printer_notes=~/.*PRINTER_VENDOR_PRUSA3D.*/ and printer_notes=~/.*PRINTER_MODEL_MK2.5.*/ and nozzle_diameter[0]==0.4 and num_extruders>1
single_extruder_multi_material_priming = 0

# MK2.5 MMU2 #
[print:0.20mm NORMAL SOLUBLE INTERFACE MK2.5]
inherits = 0.20mm NORMAL SOLUBLE INTERFACE
support_material_extruder = 0
support_material_interface_extruder = 5
compatible_printers_condition = printer_notes=~/.*PRINTER_VENDOR_PRUSA3D.*/ and printer_notes=~/.*PRINTER_MODEL_MK2.5.*/ and nozzle_diameter[0]==0.4 and num_extruders>1
single_extruder_multi_material_priming = 0

# MK2.5 #
[print:0.35mm FAST MK2.5]
inherits = 0.35mm FAST
compatible_printers_condition = printer_notes=~/.*PRINTER_VENDOR_PRUSA3D.*/ and printer_notes=~/.*PRINTER_MODEL_MK2.5.*/ and nozzle_diameter[0]==0.4
single_extruder_multi_material_priming = 0

# XXXXXXxxXXXXXXXXXXXXXX
# XXX--- filament ---XXX
# XXXXXXXXxxXXXXXXXXXXXX

[filament:*common*]
cooling = 1
compatible_printers = 
# For now, all but selected filaments are disabled for the MMU 2.0
compatible_printers_condition = ! (printer_notes=~/.*PRINTER_VENDOR_PRUSA3D.*/ and printer_notes=~/.*PRINTER_MODEL_MK(2.5|3).*/ and single_extruder_multi_material)
end_filament_gcode = "; Filament-specific end gcode"
extrusion_multiplier = 1
filament_loading_speed = 28
filament_loading_speed_start = 3
filament_unloading_speed = 90
filament_unloading_speed_start = 100
filament_toolchange_delay = 0
filament_cooling_moves = 4
filament_cooling_initial_speed = 2.2
filament_cooling_final_speed = 3.4
filament_load_time = 0
filament_unload_time = 0
filament_ramming_parameters = "120 100 6.6 6.8 7.2 7.6 7.9 8.2 8.7 9.4 9.9 10.0| 0.05 6.6 0.45 6.8 0.95 7.8 1.45 8.3 1.95 9.7 2.45 10 2.95 7.6 3.45 7.6 3.95 7.6 4.45 7.6 4.95 7.6"
filament_minimal_purge_on_wipe_tower = 15
filament_cost = 0
filament_density = 0
filament_diameter = 1.75
filament_notes = ""
filament_settings_id = ""
filament_soluble = 0
min_print_speed = 15
slowdown_below_layer_time = 20
start_filament_gcode = "M900 K{if printer_notes=~/.*PRINTER_HAS_BOWDEN.*/}200{else}30{endif} ; Filament gcode"

[filament:*PLA*]
inherits = *common*
bed_temperature = 60
bridge_fan_speed = 100
disable_fan_first_layers = 1
fan_always_on = 1
fan_below_layer_time = 100
filament_colour = #FF3232
filament_max_volumetric_speed = 15
filament_type = PLA
first_layer_bed_temperature = 60
first_layer_temperature = 215
max_fan_speed = 100
min_fan_speed = 100
temperature = 210
start_filament_gcode = "M900 K{if printer_notes=~/.*PRINTER_HAS_BOWDEN.*/}200{elsif nozzle_diameter[0]==0.6}15{else}30{endif} ; Filament gcode"

[filament:*PET*]
inherits = *common*
bed_temperature = 90
bridge_fan_speed = 50
disable_fan_first_layers = 3
fan_always_on = 1
fan_below_layer_time = 20
filament_colour = #FF8000
filament_max_volumetric_speed = 8
filament_type = PET
first_layer_bed_temperature = 85
first_layer_temperature = 230
max_fan_speed = 50
min_fan_speed = 30
start_filament_gcode = "M900 K{if printer_notes=~/.*PRINTER_HAS_BOWDEN.*/}200{elsif nozzle_diameter[0]==0.6}22{else}45{endif} ; Filament gcode"
temperature = 240

[filament:*PET06*]
inherits = *PET*
compatible_printers_condition = nozzle_diameter[0]==0.6 and ! (printer_notes=~/.*PRINTER_VENDOR_PRUSA3D.*/ and printer_notes=~/.*PRINTER_MODEL_MK(2.5|3).*/ and single_extruder_multi_material)
filament_max_volumetric_speed = 15

[filament:*ABS*]
inherits = *common*
bed_temperature = 110
bridge_fan_speed = 30
cooling = 0
disable_fan_first_layers = 3
fan_always_on = 0
fan_below_layer_time = 20
filament_colour = #3A80CA
filament_max_volumetric_speed = 11
filament_ramming_parameters = "120 100 5.70968 6.03226 7 8.25806 9 9.19355 9.3871 9.77419 10.129 10.3226 10.4516 10.5161| 0.05 5.69677 0.45 6.15484 0.95 8.76774 1.45 9.20323 1.95 9.95806 2.45 10.3871 2.95 10.5677 3.45 7.6 3.95 7.6 4.45 7.6 4.95 7.6"
filament_type = ABS
first_layer_bed_temperature = 100
first_layer_temperature = 255
max_fan_speed = 30
min_fan_speed = 20
temperature = 255
start_filament_gcode = "M900 K{if printer_notes=~/.*PRINTER_HAS_BOWDEN.*/}200{elsif nozzle_diameter[0]==0.6}15{else}30{endif} ; Filament gcode"

[filament:*FLEX*]
inherits = *common*
bed_temperature = 50
bridge_fan_speed = 100
# For now, all but selected filaments are disabled for the MMU 2.0
compatible_printers_condition = nozzle_diameter[0]>0.35 and num_extruders==1 && ! (printer_notes=~/.*PRINTER_VENDOR_PRUSA3D.*/ and printer_notes=~/.*PRINTER_MODEL_MK3.*/ and single_extruder_multi_material)
cooling = 0
disable_fan_first_layers = 1
extrusion_multiplier = 1.2
fan_always_on = 0
fan_below_layer_time = 100
filament_colour = #00CA0A
filament_max_volumetric_speed = 1.5
filament_type = FLEX
first_layer_bed_temperature = 50
first_layer_temperature = 240
max_fan_speed = 90
min_fan_speed = 70
start_filament_gcode = "M900 K{if printer_notes=~/.*PRINTER_HAS_BOWDEN.*/}200{else}10{endif}; Filament gcode"
temperature = 240

[filament:ColorFabb Brass Bronze]
inherits = *PLA*
# For now, all but selected filaments are disabled for the MMU 2.0
compatible_printers_condition = nozzle_diameter[0]>0.35 and ! (printer_notes=~/.*PRINTER_VENDOR_PRUSA3D.*/ and printer_notes=~/.*PRINTER_MODEL_MK(2.5|3).*/ and single_extruder_multi_material)
extrusion_multiplier = 1.2
filament_cost = 56.64
filament_density = 3.9
filament_colour = #804040
filament_max_volumetric_speed = 9
filament_notes = "List of materials tested with standard print settings:\n\nColorFabb bronzeFill\nColorFabb brassFill\nColorFabb steelFill\nColorFabb copperFill"

[filament:ColorFabb HT]
inherits = *PET*
bed_temperature = 110
bridge_fan_speed = 30
cooling = 1
disable_fan_first_layers = 3
fan_always_on = 0
fan_below_layer_time = 10
filament_cost = 58.66
filament_density = 1.18
first_layer_bed_temperature = 105
first_layer_temperature = 270
max_fan_speed = 20
min_fan_speed = 10
start_filament_gcode = "M900 K{if printer_notes=~/.*PRINTER_HAS_BOWDEN.*/}200{else}45{endif}; Filament gcode"
temperature = 270

[filament:ColorFabb PLA-PHA]
inherits = *PLA*
filament_cost = 55.5
filament_density = 1.24

[filament:ColorFabb woodFill]
inherits = *PLA*
# For now, all but selected filaments are disabled for the MMU 2.0
compatible_printers_condition = nozzle_diameter[0]>0.35 and ! (printer_notes=~/.*PRINTER_VENDOR_PRUSA3D.*/ and printer_notes=~/.*PRINTER_MODEL_MK(2.5|3).*/ and single_extruder_multi_material)
extrusion_multiplier = 1.2
filament_cost = 62.9
filament_density = 1.15
filament_colour = #dfc287
filament_max_volumetric_speed = 10
first_layer_temperature = 200
start_filament_gcode = "M900 K{if printer_notes=~/.*PRINTER_HAS_BOWDEN.*/}200{else}10{endif}; Filament gcode"
temperature = 200

[filament:ColorFabb corkFill]
inherits = *PLA*
compatible_printers_condition = nozzle_diameter[0]>0.35 and ! (printer_notes=~/.*PRINTER_VENDOR_PRUSA3D.*/ and printer_notes=~/.*PRINTER_MODEL_MK(2.5|3).*/ and single_extruder_multi_material)
extrusion_multiplier = 1.2
filament_cost = 45.45
filament_density = 1.18
filament_colour = #634d33
filament_max_volumetric_speed = 6
first_layer_temperature = 220
start_filament_gcode = "M900 K{if printer_notes=~/.*PRINTER_HAS_BOWDEN.*/}200{else}10{endif}; Filament gcode"
temperature = 220

[filament:ColorFabb XT]
inherits = *PET*
filament_type = PET
filament_cost = 62.9
filament_density = 1.27
first_layer_bed_temperature = 90
first_layer_temperature = 260
temperature = 270

[filament:ColorFabb XT-CF20]
inherits = *PET*
compatible_printers_condition = nozzle_diameter[0]>0.35 and ! (printer_notes=~/.*PRINTER_VENDOR_PRUSA3D.*/ and printer_notes=~/.*PRINTER_MODEL_MK(2.5|3).*/ and single_extruder_multi_material)
extrusion_multiplier = 1.2
filament_cost = 80.65
filament_density = 1.35
filament_colour = #804040
filament_max_volumetric_speed = 1
first_layer_bed_temperature = 90
first_layer_temperature = 260
start_filament_gcode = "M900 K{if printer_notes=~/.*PRINTER_HAS_BOWDEN.*/}200{else}30{endif}; Filament gcode"
temperature = 260

[filament:ColorFabb nGen]
inherits = *PET*
filament_cost = 21.2
filament_density = 1.2
bridge_fan_speed = 40
fan_always_on = 0
fan_below_layer_time = 10
filament_type = NGEN
first_layer_temperature = 240
max_fan_speed = 35
min_fan_speed = 20

[filament:ColorFabb nGen flex]
inherits = *FLEX*
filament_cost = 0
filament_density = 1
bed_temperature = 85
bridge_fan_speed = 40
cooling = 1
disable_fan_first_layers = 3
extrusion_multiplier = 1
fan_below_layer_time = 10
filament_max_volumetric_speed = 5
first_layer_bed_temperature = 85
first_layer_temperature = 260
max_fan_speed = 35
min_fan_speed = 20
temperature = 260

[filament:E3D Edge]
inherits = *PET*
filament_cost = 56.9
filament_density = 1.26
filament_notes = "List of manufacturers tested with standard PET print settings:\n\nE3D Edge\nFillamentum CPE GH100\nPlasty Mladec PETG"

[filament:E3D PC-ABS]
inherits = *ABS*
filament_cost = 0
filament_density = 1.05
first_layer_temperature = 270
temperature = 270

[filament:Fillamentum ABS]
inherits = *ABS*
filament_cost = 32.4
filament_density = 1.04
first_layer_temperature = 240
temperature = 240

[filament:Fillamentum ASA]
inherits = *ABS*
filament_cost = 38.7
filament_density = 1.04
fan_always_on = 1
first_layer_temperature = 265
temperature = 265

[filament:Fillamentum CPE HG100 HM100]
inherits = *PET*
filament_cost = 54.1
filament_density = 1.25
filament_notes = "CPE HG100 , CPE HM100"
first_layer_bed_temperature = 90
first_layer_temperature = 275
max_fan_speed = 50
min_fan_speed = 50
temperature = 275

[filament:Fillamentum Timberfill]
inherits = *PLA*
# For now, all but selected filaments are disabled for the MMU 2.0
compatible_printers_condition = nozzle_diameter[0]>0.35 and ! (printer_notes=~/.*PRINTER_VENDOR_PRUSA3D.*/ and printer_notes=~/.*PRINTER_MODEL_MK(2.5|3).*/ and single_extruder_multi_material)
extrusion_multiplier = 1.2
filament_cost = 68
filament_density = 1.15
filament_colour = #804040
filament_max_volumetric_speed = 10
first_layer_temperature = 190
start_filament_gcode = "M900 K{if printer_notes=~/.*PRINTER_HAS_BOWDEN.*/}200{else}10{endif}; Filament gcode"
temperature = 190

[filament:Generic ABS]
inherits = *ABS*
filament_cost = 27.82
filament_density = 1.04
filament_notes = "List of materials tested with standard ABS print settings:\n\nEsun ABS\nFil-A-Gehr ABS\nHatchboxABS\nPlasty Mladec ABS"

[filament:Generic PET]
inherits = *PET*
filament_cost = 27.82
filament_density = 1.27
filament_notes = "List of manufacturers tested with standard PET print settings:\n\nE3D Edge\nFillamentum CPE GH100\nPlasty Mladec PETG"

[filament:Generic PLA]
inherits = *PLA*
filament_cost = 25.4
filament_density = 1.24
filament_notes = "List of materials tested with standard PLA print settings:\n\nDas Filament\nEsun PLA\nEUMAKERS PLA\nFiberlogy HD-PLA\nFillamentum PLA\nFloreon3D\nHatchbox PLA\nPlasty Mladec PLA\nPrimavalue PLA\nProto pasta Matte Fiber\nVerbatim PLA\nVerbatim BVOH"

[filament:Polymaker PC-Max]
inherits = *ABS*
filament_cost = 77.3
filament_density = 1.20
bed_temperature = 115
filament_colour = #3A80CA
first_layer_bed_temperature = 100
first_layer_temperature = 270
temperature = 270

[filament:PrimaSelect PVA+]
inherits = *PLA*
filament_cost = 108
filament_density = 1.23
cooling = 0
fan_always_on = 0
filament_colour = #FFFFD7
filament_max_volumetric_speed = 4
filament_notes = "List of materials tested with standard PVA print settings:\n\nPrimaSelect PVA+\nICE FILAMENTS PVA 'NAUGHTY NATURAL'"
filament_ramming_parameters = "120 100 8.3871 8.6129 8.93548 9.22581 9.48387 9.70968 9.87097 10.0323 10.2258 10.4194 10.6452 10.8065| 0.05 8.34193 0.45 8.73548 0.95 9.34836 1.45 9.78385 1.95 10.0871 2.45 10.5161 2.95 10.8903 3.45 7.6 3.95 7.6 4.45 7.6 4.95 7.6"
filament_soluble = 1
filament_type = PLA
first_layer_temperature = 195
start_filament_gcode = "M900 K{if printer_notes=~/.*PRINTER_HAS_BOWDEN.*/}200{else}10{endif}; Filament gcode"
temperature = 195

[filament:Prusa ABS]
inherits = *ABS*
filament_cost = 27.82
filament_density = 1.08
filament_notes = "List of materials tested with standard ABS print settings:\n\nEsun ABS\nFil-A-Gehr ABS\nHatchboxABS\nPlasty Mladec ABS"

[filament:*ABS MMU2*]
inherits = Prusa ABS
compatible_printers_condition = printer_notes=~/.*PRINTER_VENDOR_PRUSA3D.*/ and printer_notes=~/.*PRINTER_MODEL_MK(2.5|3).*/ and single_extruder_multi_material
filament_cooling_final_speed = 50 
filament_cooling_initial_speed = 10
filament_cooling_moves = 5
filament_ramming_parameters = "120 110 5.32258 5.45161 5.67742 6 6.48387 7.12903 7.90323 8.70968 9.3871 9.83871 10.0968 10.2258| 0.05 5.30967 0.45 5.50967 0.95 6.1871 1.45 7.39677 1.95 9.05484 2.45 10 2.95 10.3098 3.45 13.0839 3.95 7.6 4.45 7.6 4.95 7.6";
filament_loading_speed_start = 19
filament_load_time = 15
filament_unload_time = 12
filament_loading_speed = 14
filament_unloading_speed = 20

[filament:Generic ABS MMU2]
inherits = *ABS MMU2*

[filament:Prusa ABS MMU2]
inherits = *ABS MMU2*

[filament:Prusa HIPS]
inherits = *ABS*
filament_cost = 27.3
filament_density = 1.04
bridge_fan_speed = 50
cooling = 1
extrusion_multiplier = 0.9
fan_always_on = 1
fan_below_layer_time = 10
filament_colour = #FFFFD7
filament_soluble = 1
filament_type = HIPS
first_layer_temperature = 220
max_fan_speed = 20
min_fan_speed = 20
start_filament_gcode = "M900 K{if printer_notes=~/.*PRINTER_HAS_BOWDEN.*/}200{else}10{endif}; Filament gcode"
temperature = 220

[filament:Prusa PET]
inherits = *PET*
filament_cost = 27.82
filament_density = 1.27
filament_notes = "List of manufacturers tested with standard PET print settings:\n\nE3D Edge\nPlasty Mladec PETG"
compatible_printers_condition = nozzle_diameter[0]!=0.6 and ! (printer_notes=~/.*PRINTER_VENDOR_PRUSA3D.*/ and printer_notes=~/.*PRINTER_MODEL_MK(2.5|3).*/ and single_extruder_multi_material)

[filament:Prusament PETG]
inherits = *PET*
first_layer_temperature = 240
temperature = 250
filament_cost = 24.99
filament_density = 1.27
compatible_printers_condition = nozzle_diameter[0]!=0.6 and ! (printer_notes=~/.*PRINTER_VENDOR_PRUSA3D.*/ and printer_notes=~/.*PRINTER_MODEL_MK(2.5|3).*/ and single_extruder_multi_material)

[filament:Prusa PET 0.6 nozzle]
inherits = *PET06*
filament_cost = 27.82
filament_density = 1.27
filament_notes = "List of manufacturers tested with standard PET print settings:\n\nE3D Edge\nPlasty Mladec PETG"

[filament:Prusament PETG 0.6 nozzle]
inherits = *PET06*
first_layer_temperature = 240
temperature = 250
filament_cost = 24.99
filament_density = 1.27

[filament:*PET MMU2*]
inherits = Prusa PET
compatible_printers_condition = printer_notes=~/.*PRINTER_VENDOR_PRUSA3D.*/ and printer_notes=~/.*PRINTER_MODEL_MK(2.5|3).*/ and single_extruder_multi_material
temperature = 230
first_layer_temperature = 230
filament_cooling_final_speed = 1
filament_cooling_initial_speed = 2
filament_cooling_moves = 1
filament_load_time = 15
filament_loading_speed = 14
filament_notes = PET
filament_ramming_parameters = "120 140 4.70968 4.74194 4.77419 4.80645 4.83871 4.87097 4.90323 5 5.25806 5.67742 6.29032 7.06452 7.83871 8.3871| 0.05 4.72901 0.45 4.73545 0.95 4.83226 1.45 4.88067 1.95 5.05483 2.45 5.93553 2.95 7.53556 3.45 8.6323 3.95 7.6 4.45 7.6 4.95 7.6"
filament_unload_time = 12
filament_unloading_speed = 20
filament_unloading_speed_start = 120
filament_loading_speed_start = 19

[filament:Generic PET MMU2]
inherits = *PET MMU2*

[filament:Prusa PET MMU2]
inherits = *PET MMU2*

[filament:Prusament PETG MMU2]
inherits = *PET MMU2*

[filament:Prusa PLA]
inherits = *PLA*
filament_cost = 25.4
filament_density = 1.24
filament_notes = "List of materials tested with standard PLA print settings:\n\nDas Filament\nEsun PLA\nEUMAKERS PLA\nFiberlogy HD-PLA\nFillamentum PLA\nFloreon3D\nHatchbox PLA\nPlasty Mladec PLA\nPrimavalue PLA\nProto pasta Matte Fiber\nVerbatim PLA\nVerbatim BVOH"

[filament:Prusament PLA]
inherits = *PLA*
temperature = 215
filament_cost = 24.99
filament_density = 1.24
filament_notes = "Affordable filament for everyday printing in premium quality manufactured in-house by Josef Prusa"

[filament:*PLA MMU2*]
inherits = Prusa PLA
compatible_printers_condition = printer_notes=~/.*PRINTER_VENDOR_PRUSA3D.*/ and printer_notes=~/.*PRINTER_MODEL_MK(2.5|3).*/ and single_extruder_multi_material
temperature = 205
filament_cooling_final_speed = 2
filament_cooling_initial_speed = 3
filament_cooling_moves = 1
filament_load_time = 15
filament_loading_speed = 14
filament_ramming_parameters = "130 120 2.70968 2.93548 3.32258 3.83871 4.58065 5.54839 6.51613 7.35484 7.93548 8.16129| 0.05 2.66451 0.45 3.05805 0.95 4.05807 1.45 5.97742 1.95 7.69999 2.45 8.1936 2.95 11.342 3.45 11.4065 3.95 7.6 4.45 7.6 4.95 7.6"
filament_unload_time = 12
filament_unloading_speed = 20
filament_loading_speed_start = 19
filament_minimal_purge_on_wipe_tower = 15
filament_unloading_speed_start = 100

[filament:Generic PLA MMU2]
inherits = *PLA MMU2*

[filament:Prusa PLA MMU2]
inherits = *PLA MMU2*

[filament:Prusament PLA MMU2]
inherits = *PLA MMU2*

[filament:SemiFlex or Flexfill 98A]
inherits = *FLEX*
filament_cost = 82
filament_density = 1.22

[filament:Taulman Bridge]
inherits = *common*
filament_cost = 40
filament_density = 1.13
bed_temperature = 90
bridge_fan_speed = 40
cooling = 0
disable_fan_first_layers = 3
fan_always_on = 0
fan_below_layer_time = 20
filament_colour = #DEE0E6
filament_max_volumetric_speed = 10
filament_soluble = 0
filament_type = PET
first_layer_bed_temperature = 60
first_layer_temperature = 240
max_fan_speed = 5
min_fan_speed = 0
start_filament_gcode = "M900 K{if printer_notes=~/.*PRINTER_HAS_BOWDEN.*/}200{else}10{endif}; Filament gcode"
temperature = 250

[filament:Taulman T-Glase]
inherits = *PET*
filament_cost = 40
filament_density = 1.27
bridge_fan_speed = 40
cooling = 0
fan_always_on = 0
first_layer_bed_temperature = 90
first_layer_temperature = 240
max_fan_speed = 5
min_fan_speed = 0
start_filament_gcode = "M900 K{if printer_notes=~/.*PRINTER_HAS_BOWDEN.*/}200{else}30{endif}; Filament gcode"

[filament:Verbatim BVOH]
inherits = *common*
filament_cost = 218
filament_density = 1.23
bed_temperature = 60
bridge_fan_speed = 100
cooling = 0
disable_fan_first_layers = 1
extrusion_multiplier = 1
fan_always_on = 0
fan_below_layer_time = 100
filament_colour = #FFFFD7
filament_max_volumetric_speed = 4
filament_notes = "List of materials tested with standard PVA print settings:\n\nVerbatim BVOH"
filament_soluble = 1
filament_type = PLA
first_layer_bed_temperature = 60
first_layer_temperature = 215
max_fan_speed = 100
min_fan_speed = 100
start_filament_gcode = "M900 K{if printer_notes=~/.*PRINTER_HAS_BOWDEN.*/}200{else}10{endif}; Filament gcode"
temperature = 210

[filament:Verbatim BVOH MMU2]
inherits = Verbatim BVOH
compatible_printers_condition = printer_notes=~/.*PRINTER_VENDOR_PRUSA3D.*/ and printer_notes=~/.*PRINTER_MODEL_MK(2.5|3).*/ and single_extruder_multi_material
temperature = 195
fan_always_on = 1
first_layer_temperature = 200
filament_cooling_final_speed = 1
filament_cooling_initial_speed = 2
filament_max_volumetric_speed = 4
filament_type = PLA
filament_cooling_moves = 1
filament_load_time = 15
filament_loading_speed = 14
filament_ramming_parameters = "120 110 1.74194 1.90323 2.16129 2.48387 2.83871 3.25806 3.83871 4.6129 5.41935 5.96774| 0.05 1.69677 0.45 1.96128 0.95 2.63872 1.45 3.46129 1.95 4.99031 2.45 6.12908 2.95 8.30974 3.45 11.4065 3.95 7.6 4.45 7.6 4.95 7.6"
filament_unload_time = 12
filament_unloading_speed = 20
filament_unloading_speed_start = 100
filament_loading_speed_start = 19

[filament:PrimaSelect PVA+ MMU2]
inherits = *common*
compatible_printers_condition = printer_notes=~/.*PRINTER_VENDOR_PRUSA3D.*/ and printer_notes=~/.*PRINTER_MODEL_MK(2.5|3).*/ and single_extruder_multi_material
bed_temperature = 60
bridge_fan_speed = 100
cooling = 0
disable_fan_first_layers = 1
fan_always_on = 0
fan_below_layer_time = 100
filament_colour = #FFFFD7
filament_cooling_final_speed = 2
filament_cooling_initial_speed = 4
filament_cooling_moves = 2
filament_cost = 25.4
filament_density = 1.24
filament_diameter = 1.75
filament_load_time = 15
filament_loading_speed = 14
filament_loading_speed_start = 19
filament_max_volumetric_speed = 4
filament_minimal_purge_on_wipe_tower = 5
filament_notes = "List of materials tested with standard PVA print settings:\n\nPrimaSelect PVA+"
filament_ramming_parameters = "120 110 3.83871 3.90323 3.96774 4.03226 4.09677 4.19355 4.3871 4.83871 5.67742 6.93548 8.54839 10.3226 11.9677 13.2581 14.129 14.5806| 0.05 3.8258 0.45 3.89676 0.95 4.05807 1.45 4.23548 1.95 5.18386 2.45 7.80651 2.95 11.5356 3.45 13.9872 3.95 14.7613 4.45 7.6 4.95 7.6"
filament_soluble = 1
filament_toolchange_delay = 0
filament_type = PLA
filament_unload_time = 12
filament_unloading_speed = 20
filament_unloading_speed_start = 100
first_layer_bed_temperature = 60
first_layer_temperature = 200
max_fan_speed = 100
min_fan_speed = 100
min_print_speed = 15
slowdown_below_layer_time = 20
start_filament_gcode = "M900 K{if printer_notes=~/.*PRINTER_HAS_BOWDEN.*/}200{else}30{endif}; Filament gcode"
temperature = 195

[filament:Verbatim PP]
inherits = *common*
filament_cost = 72
filament_density = 0.89
bed_temperature = 100
bridge_fan_speed = 100
cooling = 1
disable_fan_first_layers = 2
extrusion_multiplier = 1
fan_always_on = 1
fan_below_layer_time = 100
filament_colour = #DEE0E6
filament_max_volumetric_speed = 5
filament_notes = "List of materials tested with standard PLA print settings:\n\nEsun PLA\nFiberlogy HD-PLA\nFillamentum PLA\nFloreon3D\nHatchbox PLA\nPlasty Mladec PLA\nPrimavalue PLA\nProto pasta Matte Fiber\nEUMAKERS PLA"
filament_type = PLA
first_layer_bed_temperature = 100
first_layer_temperature = 220
max_fan_speed = 100
min_fan_speed = 100
start_filament_gcode = "M900 K{if printer_notes=~/.*PRINTER_HAS_BOWDEN.*/}200{else}10{endif}; Filament gcode"
temperature = 220

[sla_print:*common*]
compatible_printers_condition = printer_notes=~/.*PRINTER_VENDOR_PRUSA3D.*/ and printer_notes=~/.*PRINTER_MODEL_SL1.*/
layer_height = 0.05
output_filename_format = [input_filename_base].sl1
pad_edge_radius = 0.5
pad_enable = 1
pad_max_merge_distance = 50
pad_wall_height = 0
pad_wall_thickness = 1
pad_wall_slope = 90
slice_closing_radius = 0.005
support_base_diameter = 3
support_base_height = 1
support_critical_angle = 45
support_density_at_45 = 250
support_density_at_horizontal = 500
support_head_front_diameter = 0.4
support_head_penetration = 0.4
support_head_width = 3
support_max_bridge_length = 10
support_minimal_z = 0
support_object_elevation = 5
support_pillar_diameter = 1
support_pillar_connection_mode = zigzag
support_pillar_widening_factor = 0
supports_enable = 1

[sla_print:0.025 UltraDetail]
inherits = *common*
layer_height = 0.025
support_head_width = 2

[sla_print:0.035 Detail]
inherits = *common*
layer_height = 0.035

[sla_print:0.05 Normal]
inherits = *common*
layer_height = 0.05

[sla_print:0.1 Fast]
inherits = *common*
layer_height = 0.1

########### Materials 0.025

[sla_material:*common 0.05*]
compatible_printers_condition = printer_notes=~/.*PRINTER_VENDOR_PRUSA3D.*/ and printer_notes=~/.*PRINTER_MODEL_SL1.*/
compatible_prints_condition = layer_height == 0.05
exposure_time = 12
initial_exposure_time = 45
initial_layer_height = 0.05
material_correction = 1,1,1
material_notes = 

[sla_material:*common 0.025*]
inherits = *common 0.05*
compatible_prints_condition = layer_height == 0.025
exposure_time = 10
initial_exposure_time = 35
initial_layer_height = 0.025

[sla_material:*common 0.035*]
inherits = *common 0.05*
compatible_prints_condition = layer_height == 0.035
exposure_time = 13
initial_exposure_time = 40
initial_layer_height = 0.035

[sla_material:*common 0.1*]
inherits = *common 0.05*
compatible_prints_condition = layer_height == 0.1
exposure_time = 20
initial_exposure_time = 90
initial_layer_height = 0.1

########### Materials 0.025

[sla_material:Bluecast Phrozen Wax 0.025]
inherits = *common 0.025*
exposure_time = 8
initial_exposure_time = 45

[sla_material:Prusa Orange Tough 0.025]
inherits = *common 0.025*
exposure_time = 6
initial_exposure_time = 30

########### Materials 0.05

[sla_material:3DM-HTR140 (high temperature) 0.05]
inherits = *common 0.05*
exposure_time = 12
initial_exposure_time = 45

[sla_material:Bluecast Ecogray 0.05]
inherits = *common 0.05*
exposure_time = 8
initial_exposure_time = 45

[sla_material:Bluecast Keramaster 0.05]
inherits = *common 0.05*
exposure_time = 8
initial_exposure_time = 45

[sla_material:Bluecast Keramaster Dental 0.05]
inherits = *common 0.05*
exposure_time = 7
initial_exposure_time = 45

[sla_material:Bluecast LCD-DLP Original 0.05]
inherits = *common 0.05*
exposure_time = 10
initial_exposure_time = 60

[sla_material:Bluecast Phrozen Wax 0.05]
inherits = *common 0.05*
exposure_time = 10
initial_exposure_time = 55

[sla_material:Bluecast S+ 0.05]
inherits = *common 0.05*
exposure_time = 9
initial_exposure_time = 45

[sla_material:Bluecast X2 0.05]
inherits = *common 0.05*
exposure_time = 10
initial_exposure_time = 60

[sla_material:Prusa Skin Tough 0.05]
inherits = *common 0.05*
exposure_time = 6
initial_exposure_time = 30

[sla_material:Prusa Orange Tough 0.05]
inherits = *common 0.05*
exposure_time = 7.5
initial_exposure_time = 30

[sla_material:Prusa Grey Tough 0.05]
inherits = *common 0.05*
exposure_time = 8.5
initial_exposure_time = 30

[sla_material:Prusa Black Tough 0.05]
inherits = *common 0.05*
exposure_time = 6
initial_exposure_time = 30

[sla_material:Monocure 3D Black Rapid Resin 0.05]
inherits = *common 0.05*
exposure_time = 6
initial_exposure_time = 40

[sla_material:Monocure 3D Blue Rapid Resin 0.05]
inherits = *common 0.05*
exposure_time = 7
initial_exposure_time = 40

[sla_material:Monocure 3D Clear Rapid Resin 0.05]
inherits = *common 0.05*
exposure_time = 8
initial_exposure_time = 40

[sla_material:Monocure 3D Gray Rapid Resin 0.05]
inherits = *common 0.05*
exposure_time = 7
initial_exposure_time = 40

[sla_material:Monocure 3D White Rapid Resin 0.05]
inherits = *common 0.05*
exposure_time = 7
initial_exposure_time = 40

[sla_material:3DM-ABS 0.05]
inherits = *common 0.05*
exposure_time = 9
initial_exposure_time = 35

[sla_material:3DM-DENT 0.05]
inherits = *common 0.05*
exposure_time = 7
initial_exposure_time = 45

[sla_material:3DM-HR Green 0.05]
inherits = *common 0.05*
exposure_time = 15
initial_exposure_time = 40

[sla_material:3DM-HR Red Wine 0.05]
inherits = *common 0.05*
exposure_time = 9
initial_exposure_time = 35

[sla_material:3DM-XPRO White 0.05]
inherits = *common 0.05*
exposure_time = 9
initial_exposure_time = 35

[sla_material:FTD Ash Grey 0.05]
inherits = *common 0.05*
exposure_time = 9
initial_exposure_time = 40

## [sla_material:Prusa Skin Super Low Odor 0.05]
## inherits = *common 0.05*
## exposure_time = 7.5
## initial_exposure_time = 30

## [sla_material:Prusa White Super Low Odor 0.05]
## inherits = *common 0.05*
## exposure_time = 6.5
## initial_exposure_time = 30

## [sla_material:Prusa Grey Super Low Odor 0.05]
## inherits = *common 0.05*
## exposure_time = 6.5
## initial_exposure_time = 30

[sla_material:Harz Labs Model Resin Cherry 0.05]
inherits = *common 0.05*
exposure_time = 8
initial_exposure_time = 45

## [sla_material:Prusa Black High Tenacity 0.05]
## inherits = *common 0.05*
## exposure_time = 7
## initial_exposure_time = 30

[sla_material:Prusa Green Casting 0.05]
inherits = *common 0.05*
exposure_time = 13
initial_exposure_time = 30

## [sla_material:Prusa Yellow Solid 0.05]
## inherits = *common 0.05*
## exposure_time = 7
## initial_exposure_time = 30

[sla_material:Prusa White Tough 0.05]
inherits = *common 0.05*
exposure_time = 7
initial_exposure_time = 30

## [sla_material:Prusa Green Transparent 0.05]
## inherits = *common 0.05*
## exposure_time = 6
## initial_exposure_time = 30

[sla_material:Prusa Transparent Red Tough 0.05]
inherits = *common 0.05*
exposure_time = 6
initial_exposure_time = 30

[sla_material:Prusa Maroon Tough 0.05]
inherits = *common 0.05*
exposure_time = 9
initial_exposure_time = 30

[sla_material:Prusa Pink Tough 0.05]
inherits = *common 0.05*
exposure_time = 7
initial_exposure_time = 30

[sla_material:Prusa Azure Blue Tough 0.05]
inherits = *common 0.05*
exposure_time = 8
initial_exposure_time = 30

## [sla_material:Prusa Yellow Flexible 0.05]
## inherits = *common 0.05*
## exposure_time = 9
## initial_exposure_time = 30

## [sla_material:Prusa Clear Flexible 0.05]
## inherits = *common 0.05*
## exposure_time = 9
## initial_exposure_time = 30

## [sla_material:Prusa White Flexible 0.05]
## inherits = *common 0.05*
## exposure_time = 9
## initial_exposure_time = 30

## [sla_material:Prusa Blue Flexible 0.05]
## inherits = *common 0.05*
## exposure_time = 9
## initial_exposure_time = 30

## [sla_material:Prusa Black Flexible 0.05]
## inherits = *common 0.05*
## exposure_time = 9
## initial_exposure_time = 30

## [sla_material:Prusa Red Flexible 0.05]
## inherits = *common 0.05*
## exposure_time = 9
## initial_exposure_time = 30

########### Materials 0.035

[sla_material:Prusa Orange Tough 0.035]
inherits = *common 0.035*
exposure_time = 6
initial_exposure_time = 30

########### Materials 0.1

[sla_material:Prusa Orange Tough 0.1]
inherits = *common 0.1*
exposure_time = 10
initial_exposure_time = 30

[printer:*common*]
printer_technology = FFF
bed_shape = 0x0,250x0,250x210,0x210
before_layer_gcode = ;BEFORE_LAYER_CHANGE\nG92 E0.0\n;[layer_z]\n\n
between_objects_gcode = 
deretract_speed = 0
end_gcode = G4 ; wait\nM104 S0 ; turn off temperature\nM140 S0 ; turn off heatbed\nM107 ; turn off fan\n{if layer_z < max_print_height}G1 Z{z_offset+min(layer_z+30, max_print_height)}{endif} ; Move print head up\nG1 X0 Y200 F3000 ; home X axis\nM84 ; disable motors
extruder_colour = #FFFF00
extruder_offset = 0x0
gcode_flavor = marlin
silent_mode = 0
remaining_times = 1
machine_max_acceleration_e = 10000
machine_max_acceleration_extruding = 2000
machine_max_acceleration_retracting = 1500
machine_max_acceleration_x = 9000
machine_max_acceleration_y = 9000
machine_max_acceleration_z = 500
machine_max_feedrate_e = 120
machine_max_feedrate_x = 500
machine_max_feedrate_y = 500
machine_max_feedrate_z = 12
machine_max_jerk_e = 2.5
machine_max_jerk_x = 10
machine_max_jerk_y = 10
machine_max_jerk_z = 0.2
machine_min_extruding_rate = 0
machine_min_travel_rate = 0
layer_gcode = ;AFTER_LAYER_CHANGE\n;[layer_z]
max_layer_height = 0.25
min_layer_height = 0.07
max_print_height = 200
nozzle_diameter = 0.4
octoprint_apikey = 
octoprint_host = 
printer_notes = Don't remove the following keywords! These keywords are used in the "compatible printer" condition of the print and filament profiles to link the particular print and filament profiles to this printer profile.\nPRINTER_VENDOR_PRUSA3D\nPRINTER_MODEL_MK2\n
printer_settings_id = 
retract_before_travel = 1
retract_before_wipe = 0%
retract_layer_change = 1
retract_length = 0.8
retract_length_toolchange = 4
retract_lift = 0.6
retract_lift_above = 0
retract_lift_below = 199
retract_restart_extra = 0
retract_restart_extra_toolchange = 0
retract_speed = 35
serial_port = 
serial_speed = 250000
single_extruder_multi_material = 0
start_gcode = M115 U3.1.0 ; tell printer latest fw version\nG90 ; use absolute coordinates\nM83 ; extruder relative mode\nM204 S[machine_max_acceleration_extruding] T[machine_max_acceleration_retracting] ; MK2 firmware only supports the old M204 format\nM104 S[first_layer_temperature] ; set extruder temp\nM140 S[first_layer_bed_temperature] ; set bed temp\nM190 S[first_layer_bed_temperature] ; wait for bed temp\nM109 S[first_layer_temperature] ; wait for extruder temp\nG28 W ; home all without mesh bed level\nG80 ; mesh bed leveling\nG1 Y-3.0 F1000.0 ; go outside print area\nG92 E0.0\nG1 X60.0 E9.0  F1000.0 ; intro line\nG1 X100.0 E12.5 F1000.0 ; intro line\nG92 E0.0
toolchange_gcode = 
use_firmware_retraction = 0
use_relative_e_distances = 1
use_volumetric_e = 0
variable_layer_height = 1
wipe = 1
z_offset = 0
printer_model = MK2S
printer_variant = 0.4
default_print_profile = 0.15mm OPTIMAL
default_filament_profile = Prusament PLA

[printer:*multimaterial*]
inherits = *common*
deretract_speed = 50
retract_before_travel = 3
retract_before_wipe = 60%
retract_layer_change = 0
retract_length = 4
retract_lift = 0.6
retract_lift_above = 0
retract_lift_below = 199
retract_restart_extra = 0
retract_restart_extra_toolchange = 0
retract_speed = 80
parking_pos_retraction = 92
cooling_tube_length = 5
cooling_tube_retraction = 91.5
single_extruder_multi_material = 1
variable_layer_height = 1
printer_model = MK2SMM

[printer:*mm-single*]
inherits = *multimaterial*
end_gcode = G1 E-4 F2100.00000\nG91\nG1 Z1 F7200.000\nG90\nG1 X245 Y1\nG1 X240 E4\nG1 F4000\nG1 X190 E2.7  \nG1 F4600\nG1 X110 E2.8\nG1 F5200\nG1 X40 E3  \nG1 E-15.0000 F5000\nG1 E-50.0000 F5400\nG1 E-15.0000 F3000\nG1 E-12.0000 F2000\nG1 F1600\nG1 X0 Y1 E3.0000\nG1 X50 Y1 E-5.0000\nG1 F2000\nG1 X0 Y1 E5.0000\nG1 X50 Y1 E-5.0000\nG1 F2400\nG1 X0 Y1 E5.0000\nG1 X50 Y1 E-5.0000\nG1 F2400\nG1 X0 Y1 E5.0000\nG1 X50 Y1 E-3.0000\nG4 S0\nM107 ; turn off fan\n{if layer_z < max_print_height}G1 Z{z_offset+min(layer_z+30, max_print_height)}{endif} ; Move print head up\nM104 S0 ; turn off temperature\nM140 S0 ; turn off heatbed\nG28 X0  ; home X axis\nM84     ; disable motors\n\n
printer_notes = Don't remove the following keywords! These keywords are used in the "compatible printer" condition of the print and filament profiles to link the particular print and filament profiles to this printer profile.\nPRINTER_VENDOR_PRUSA3D\nPRINTER_MODEL_MK2\nPRINTER_HAS_BOWDEN
start_gcode = M115 U3.1.0 ; tell printer latest fw version\nM204 S[machine_max_acceleration_extruding] T[machine_max_acceleration_retracting] ; MK2 firmware only supports the old M204 format\n; Start G-Code sequence START\nT?\nM104 S[first_layer_temperature]\nM140 S[first_layer_bed_temperature]\nM109 S[first_layer_temperature]\nM190 S[first_layer_bed_temperature]\nG21 ; set units to millimeters\nG90 ; use absolute coordinates\nM83 ; use relative distances for extrusion\nG28 W\nG80\nG92 E0.0\nM203 E100\nM92 E140\nG1 Z0.250 F7200.000\nG1 X50.0 E80.0 F1000.0\nG1 X160.0 E20.0 F1000.0\nG1 Z0.200 F7200.000\nG1 X220.0 E13 F1000.0\nG1 X240.0 E0 F1000.0\nG92 E0.0
default_print_profile = 0.15mm OPTIMAL

[printer:*mm-multi*]
inherits = *multimaterial*
high_current_on_filament_swap = 1
end_gcode = {if not has_wipe_tower}\n; Pull the filament into the cooling tubes.\nG1 E-4 F2100.00000\nG91\nG1 Z1 F7200.000\nG90\nG1 X245 Y1\nG1 X240 E4\nG1 F4000\nG1 X190 E2.7  \nG1 F4600\nG1 X110 E2.8\nG1 F5200\nG1 X40 E3  \nG1 E-15.0000 F5000\nG1 E-50.0000 F5400\nG1 E-15.0000 F3000\nG1 E-12.0000 F2000\nG1 F1600\nG1 X0 Y1 E3.0000\nG1 X50 Y1 E-5.0000\nG1 F2000\nG1 X0 Y1 E5.0000\nG1 X50 Y1 E-5.0000\nG1 F2400\nG1 X0 Y1 E5.0000\nG1 X50 Y1 E-5.0000\nG1 F2400\nG1 X0 Y1 E5.0000\nG1 X50 Y1 E-3.0000\nG4 S0\n{endif}\nM107 ; turn off fan\n{if layer_z < max_print_height}G1 Z{z_offset+min(layer_z+30, max_print_height)}{endif} ; Move print head up\nM104 S0 ; turn off temperature\nM140 S0 ; turn off heatbed\nG28 X0  ; home X axis\nM84     ; disable motors
extruder_colour = #FFAA55;#E37BA0;#4ECDD3;#FB7259
nozzle_diameter = 0.4,0.4,0.4,0.4
printer_notes = Don't remove the following keywords! These keywords are used in the "compatible printer" condition of the print and filament profiles to link the particular print and filament profiles to this printer profile.\nPRINTER_VENDOR_PRUSA3D\nPRINTER_MODEL_MK2\nPRINTER_HAS_BOWDEN
start_gcode = M115 U3.1.0 ; tell printer latest fw version\nM204 S[machine_max_acceleration_extruding] T[machine_max_acceleration_retracting] ; MK2 firmware only supports the old M204 format\n; Start G-Code sequence START\nT[initial_tool]\nM104 S[first_layer_temperature] ; set extruder temp\nM140 S[first_layer_bed_temperature] ; set bed temp\nM190 S[first_layer_bed_temperature] ; wait for bed temp\nM109 S[first_layer_temperature] ; wait for extruder temp\nG21 ; set units to millimeters\nG90 ; use absolute coordinates\nM83 ; use relative distances for extrusion\nG28 W\nG80\nG92 E0.0\nM203 E100 ; set max feedrate\nM92 E140 ; E-steps per filament milimeter\n{if not has_single_extruder_multi_material_priming}\nG1 Z0.250 F7200.000\nG1 X50.0 E80.0 F1000.0\nG1 X160.0 E20.0 F1000.0\nG1 Z0.200 F7200.000\nG1 X220.0 E13 F1000.0\nG1 X240.0 E0 F1000.0\n{endif}\nG92 E0.0
default_print_profile = 0.15mm OPTIMAL

# XXXXXXXXXXXXXXXXX
# XXX--- MK2 ---XXX
# XXXXXXXXXXXXXXXXX

[printer:Original Prusa i3 MK2S]
inherits = *common*

[printer:Original Prusa i3 MK2S 0.25 nozzle]
inherits = *common*
max_layer_height = 0.15
min_layer_height = 0.05
nozzle_diameter = 0.25
retract_length = 1
retract_speed = 50
variable_layer_height = 1
printer_variant = 0.25
default_print_profile = 0.10mm DETAIL 0.25 nozzle

[printer:Original Prusa i3 MK2S 0.6 nozzle]
inherits = *common*
max_layer_height = 0.35
min_layer_height = 0.1
nozzle_diameter = 0.6
printer_variant = 0.6
default_print_profile = 0.20mm NORMAL 0.6 nozzle

# XXXXXXXXXXXXXXXXXXX
# XXX--- MK2MM ---XXX
# XXXXXXXXXXXXXXXXXXX

[printer:Original Prusa i3 MK2S MMU1 Single]
inherits = *mm-single*
max_layer_height = 0.25
min_layer_height = 0.07

[printer:Original Prusa i3 MK2S MMU1 Single 0.6 nozzle]
inherits = *mm-single*
nozzle_diameter = 0.6
printer_variant = 0.6
default_print_profile = 0.20mm NORMAL 0.6 nozzle
max_layer_height = 0.35
min_layer_height = 0.1

[printer:Original Prusa i3 MK2S MMU1]
inherits = *mm-multi*
nozzle_diameter = 0.4,0.4,0.4,0.4
max_layer_height = 0.25
min_layer_height = 0.07

[printer:Original Prusa i3 MK2S MMU1 0.6 nozzle]
inherits = *mm-multi*
nozzle_diameter = 0.6,0.6,0.6,0.6
printer_variant = 0.6
default_print_profile = 0.20mm NORMAL 0.6 nozzle
max_layer_height = 0.35
min_layer_height = 0.1

# XXXXXXXXXXXXXXXXXXX
# XXX--- MK2.5 ---XXX
# XXXXXXXXXXXXXXXXXXX

[printer:Original Prusa i3 MK2.5]
inherits = Original Prusa i3 MK2S
printer_model = MK2.5
remaining_times = 1
start_gcode = M115 U3.7.1 ; tell printer latest fw version\nG90 ; use absolute coordinates\nM83 ; extruder relative mode\nM104 S[first_layer_temperature] ; set extruder temp\nM140 S[first_layer_bed_temperature] ; set bed temp\nM190 S[first_layer_bed_temperature] ; wait for bed temp\nM109 S[first_layer_temperature] ; wait for extruder temp\nG28 W ; home all without mesh bed level\nG80 ; mesh bed leveling\nG1 Y-3.0 F1000.0 ; go outside print area\nG92 E0.0\nG1 X60.0 E9.0 F1000.0 ; intro line\nG1 X100.0 E12.5 F1000.0 ; intro line\nG92 E0.0

[printer:Original Prusa i3 MK2.5 0.25 nozzle]
inherits = Original Prusa i3 MK2S 0.25 nozzle
printer_model = MK2.5
remaining_times = 1
start_gcode = M115 U3.7.1 ; tell printer latest fw version\nG90 ; use absolute coordinates\nM83 ; extruder relative mode\nM104 S[first_layer_temperature] ; set extruder temp\nM140 S[first_layer_bed_temperature] ; set bed temp\nM190 S[first_layer_bed_temperature] ; wait for bed temp\nM109 S[first_layer_temperature] ; wait for extruder temp\nG28 W ; home all without mesh bed level\nG80 ; mesh bed leveling\nG1 Y-3.0 F1000.0 ; go outside print area\nG92 E0.0\nG1 X60.0 E9.0 F1000.0 ; intro line\nG1 X100.0 E12.5 F1000.0 ; intro line\nG92 E0.0

[printer:Original Prusa i3 MK2.5 0.6 nozzle]
inherits = Original Prusa i3 MK2S 0.6 nozzle
printer_model = MK2.5
remaining_times = 1
start_gcode = M115 U3.7.1 ; tell printer latest fw version\nG90 ; use absolute coordinates\nM83 ; extruder relative mode\nM104 S[first_layer_temperature] ; set extruder temp\nM140 S[first_layer_bed_temperature] ; set bed temp\nM190 S[first_layer_bed_temperature] ; wait for bed temp\nM109 S[first_layer_temperature] ; wait for extruder temp\nG28 W ; home all without mesh bed level\nG80 ; mesh bed leveling\nG1 Y-3.0 F1000.0 ; go outside print area\nG92 E0.0\nG1 X60.0 E9.0 F1000.0 ; intro line\nG1 X100.0 E12.5 F1000.0 ; intro line\nG92 E0.0

[printer:Original Prusa i3 MK2.5 MMU2 Single]
inherits = Original Prusa i3 MK2.5; *mm2*
printer_model = MK2.5MMU2
single_extruder_multi_material = 0
max_print_height = 200
remaining_times = 1
silent_mode = 0
retract_lift_below = 199
machine_max_acceleration_e = 10000
machine_max_acceleration_extruding = 2000
machine_max_acceleration_retracting = 1500
machine_max_acceleration_x = 9000
machine_max_acceleration_y = 9000
machine_max_acceleration_z = 500
machine_max_feedrate_e = 120
machine_max_feedrate_x = 500
machine_max_feedrate_y = 500
machine_max_feedrate_z = 12
machine_max_jerk_e = 2.5
machine_max_jerk_x = 10
machine_max_jerk_y = 10
machine_max_jerk_z = 0.2
machine_min_extruding_rate = 0
machine_min_travel_rate = 0
default_print_profile = 0.15mm OPTIMAL MK2.5
default_filament_profile = Prusament PLA
printer_notes = Don't remove the following keywords! These keywords are used in the "compatible printer" condition of the print and filament profiles to link the particular print and filament profiles to this printer profile.\nPRINTER_VENDOR_PRUSA3D\nPRINTER_MODEL_MK2.5\n
start_gcode = M115 U3.7.1 ; tell printer latest fw version\nG90 ; use absolute coordinates\nM83 ; extruder relative mode\nM104 S[first_layer_temperature] ; set extruder temp\nM140 S[first_layer_bed_temperature] ; set bed temp\n; select extruder\nTx\nM190 S[first_layer_bed_temperature] ; wait for bed temp\nM109 S[first_layer_temperature] ; wait for extruder temp\nG28 W ; home all without mesh bed level\nG80 ; mesh bed leveling\n\nG21 ; set units to millimeters\n\n;go outside print area\nG1 Y-3.0 F1000.0\nG1 Z0.4 F1000.0\n; load to nozzle\nTc\n; purge line\nG1 X55.0 E8.0 F2000.0\nG1 Z0.3 F1000.0\nG92 E0.0\nG1 X240.0 E25.0 F2200.0\nG1 Y-2.0 F1000.0\nG1 X55.0 E25 F1400.0\nG1 Z0.20 F1000.0\nG1 X5.0 E4.0 F1000.0\nG92 E0.0\n
end_gcode = G1 X0 Y210 F7200\nG1 E2 F5000\nG1 E2 F5500\nG1 E2 F6000\nG1 E-15.0000 F5800\nG1 E-20.0000 F5500\nG1 E10.0000 F3000\nG1 E-10.0000 F3100\nG1 E10.0000 F3150\nG1 E-10.0000 F3250\nG1 E10.0000 F3300\n\nM702 C\n\nG4 ; wait\nM104 S0 ; turn off temperature\nM140 S0 ; turn off heatbed\nM107 ; turn off fan\nG1 X0 Y200 F3000 ; home X axis\nM84 ; disable motors

[printer:Original Prusa i3 MK2.5 MMU2 Single 0.6 nozzle]
inherits = Original Prusa i3 MK2.5S MMU2S Single 0.6 nozzle
printer_model = MK2.5MMU2

[printer:Original Prusa i3 MK2.5 MMU2 Single 0.25 nozzle]
inherits = Original Prusa i3 MK2.5S MMU2S Single 0.25 nozzle
printer_model = MK2.5MMU2

[printer:Original Prusa i3 MK2.5 MMU2]
inherits = Original Prusa i3 MK2.5; *mm2*
printer_model = MK2.5MMU2
max_print_height = 200
remaining_times = 1
silent_mode = 0
retract_lift_below = 199
machine_max_acceleration_e = 10000
machine_max_acceleration_extruding = 2000
machine_max_acceleration_retracting = 1500
machine_max_acceleration_x = 9000
machine_max_acceleration_y = 9000
machine_max_acceleration_z = 500
machine_max_feedrate_e = 120
machine_max_feedrate_x = 500
machine_max_feedrate_y = 500
machine_max_feedrate_z = 12
machine_max_jerk_e = 2.5
machine_max_jerk_x = 10
machine_max_jerk_y = 10
machine_max_jerk_z = 0.2
machine_min_extruding_rate = 0
machine_min_travel_rate = 0
default_print_profile = 0.15mm OPTIMAL MK2.5
printer_notes = Don't remove the following keywords! These keywords are used in the "compatible printer" condition of the print and filament profiles to link the particular print and filament profiles to this printer profile.\nPRINTER_VENDOR_PRUSA3D\nPRINTER_MODEL_MK2.5\n
single_extruder_multi_material = 1
# The 5x nozzle diameter defines the number of extruders. Other extruder parameters
# (for example the retract values) are duplicaed from the first value, so they do not need 
# to be defined explicitely.
nozzle_diameter = 0.4,0.4,0.4,0.4,0.4
extruder_colour = #FF8000;#DB5182;#00FFFF;#FF4F4F;#9FFF9F
start_gcode = M115 U3.7.1 ; tell printer latest fw version\nG90 ; use absolute coordinates\nM83 ; extruder relative mode\nM104 S[first_layer_temperature] ; set extruder temp\nM140 S[first_layer_bed_temperature] ; set bed temp\nM190 S[first_layer_bed_temperature] ; wait for bed temp\nM109 S[first_layer_temperature] ; wait for extruder temp\nG28 W ; home all without mesh bed level\nG80 ; mesh bed leveling\nG21 ; set units to millimeters\n\n; Send the filament type to the MMU2.0 unit.\n; E stands for extruder number, F stands for filament type (0: default; 1:flex; 2: PVA)\nM403 E0 F{"" + ((filament_type[0]=="FLEX") ? 1 : ((filament_type[0]=="PVA") ? 2 : 0))}\nM403 E1 F{"" + ((filament_type[1]=="FLEX") ? 1 : ((filament_type[1]=="PVA") ? 2 : 0))}\nM403 E2 F{"" + ((filament_type[2]=="FLEX") ? 1 : ((filament_type[2]=="PVA") ? 2 : 0))}\nM403 E3 F{"" + ((filament_type[3]=="FLEX") ? 1 : ((filament_type[3]=="PVA") ? 2 : 0))}\nM403 E4 F{"" + ((filament_type[4]=="FLEX") ? 1 : ((filament_type[4]=="PVA") ? 2 : 0))}\n\n{if not has_single_extruder_multi_material_priming}\n;go outside print area\nG1 Y-3.0 F1000.0\nG1 Z0.4 F1000.0\n; select extruder\nT[initial_tool]\n; initial load\nG1 X55.0 E32.0 F1073.0\nG1 X5.0 E32.0 F1800.0\nG1 X55.0 E8.0 F2000.0\nG1 Z0.3 F1000.0\nG92 E0.0\nG1 X240.0 E25.0 F2200.0\nG1 Y-2.0 F1000.0\nG1 X55.0 E25 F1400.0\nG1 Z0.20 F1000.0\nG1 X5.0 E4.0 F1000.0\nG92 E0.0\n{endif}\nG92 E0.0\n
end_gcode = {if has_wipe_tower}\nG1 E-15.0000 F3000\n{else}\nG1 X0 Y210 F7200\nG1 E2 F5000\nG1 E2 F5500\nG1 E2 F6000\nG1 E-15.0000 F5800\nG1 E-20.0000 F5500\nG1 E10.0000 F3000\nG1 E-10.0000 F3100\nG1 E10.0000 F3150\nG1 E-10.0000 F3250\nG1 E10.0000 F3300\n{endif}\n\n; Unload filament\nM702 C\n\nG4 ; wait\nM104 S0 ; turn off temperature\nM140 S0 ; turn off heatbed\nM107 ; turn off fan\n; Lift print head a bit\n{if layer_z < max_print_height}G1 Z{z_offset+min(layer_z+30, max_print_height)}{endif} ; Move print head up\nG1 X0 Y200 F3000 ; home X axis\nM84 ; disable motors\n

[printer:Original Prusa i3 MK2.5S]
inherits = Original Prusa i3 MK2.5
printer_model = MK2.5S
start_gcode = M115 U3.7.1 ; tell printer latest fw version\nG90 ; use absolute coordinates\nM83  ; extruder relative mode\nM104 S[first_layer_temperature] ; set extruder temp\nM140 S[first_layer_bed_temperature] ; set bed temp\nM190 S[first_layer_bed_temperature] ; wait for bed temp\nM109 S[first_layer_temperature] ; wait for extruder temp\nG28 W ; home all without mesh bed level\nG80 ; mesh bed leveling\nG1 Y-3.0 F1000.0 ; go outside print area\nG92 E0.0\nG1 X60.0 E9.0 F1000.0 ; intro line\nG1 X100.0 E12.5 F1000.0 ; intro line\nG92 E0.0

[printer:Original Prusa i3 MK2.5S 0.25 nozzle]
inherits = Original Prusa i3 MK2.5 0.25 nozzle
printer_model = MK2.5S
start_gcode = M115 U3.7.1 ; tell printer latest fw version\nG90 ; use absolute coordinates\nM83 ; extruder relative mode\nM104 S[first_layer_temperature] ; set extruder temp\nM140 S[first_layer_bed_temperature] ; set bed temp\nM190 S[first_layer_bed_temperature] ; wait for bed temp\nM109 S[first_layer_temperature] ; wait for extruder temp\nG28 W ; home all without mesh bed level\nG80 ; mesh bed leveling\nG1 Y-3.0 F1000.0 ; go outside print area\nG92 E0.0\nG1 X60.0 E9.0 F1000.0 ; intro line\nG1 X100.0 E12.5 F1000.0 ; intro line\nG92 E0.0

[printer:Original Prusa i3 MK2.5S 0.6 nozzle]
inherits = Original Prusa i3 MK2.5 0.6 nozzle
printer_model = MK2.5S
start_gcode = M115 U3.7.1 ; tell printer latest fw version\nG90 ; use absolute coordinates\nM83 ; extruder relative mode\nM104 S[first_layer_temperature] ; set extruder temp\nM140 S[first_layer_bed_temperature] ; set bed temp\nM190 S[first_layer_bed_temperature] ; wait for bed temp\nM109 S[first_layer_temperature] ; wait for extruder temp\nG28 W ; home all without mesh bed level\nG80 ; mesh bed leveling\nG1 Y-3.0 F1000.0 ; go outside print area\nG92 E0.0\nG1 X60.0 E9.0 F1000.0 ; intro line\nG1 X100.0 E12.5 F1000.0 ; intro line\nG92 E0.0

[printer:Original Prusa i3 MK2.5S MMU2S Single]
inherits = Original Prusa i3 MK2.5; *mm2s*
printer_model = MK2.5SMMU2S
single_extruder_multi_material = 0
max_print_height = 200
remaining_times = 1
silent_mode = 0
retract_lift_below = 199
machine_max_acceleration_e = 10000
machine_max_acceleration_extruding = 2000
machine_max_acceleration_retracting = 1500
machine_max_acceleration_x = 9000
machine_max_acceleration_y = 9000
machine_max_acceleration_z = 500
machine_max_feedrate_e = 120
machine_max_feedrate_x = 500
machine_max_feedrate_y = 500
machine_max_feedrate_z = 12
machine_max_jerk_e = 2.5
machine_max_jerk_x = 10
machine_max_jerk_y = 10
machine_max_jerk_z = 0.2
machine_min_extruding_rate = 0
machine_min_travel_rate = 0
default_print_profile = 0.15mm OPTIMAL MK2.5
default_filament_profile = Prusament PLA
printer_notes = Don't remove the following keywords! These keywords are used in the "compatible printer" condition of the print and filament profiles to link the particular print and filament profiles to this printer profile.\nPRINTER_VENDOR_PRUSA3D\nPRINTER_MODEL_MK2.5\n
start_gcode = M115 U3.7.1 ; tell printer latest fw version\nG90 ; use absolute coordinates\nM83 ; extruder relative mode\nM104 S[first_layer_temperature] ; set extruder temp\nM140 S[first_layer_bed_temperature] ; set bed temp\nTx\nM190 S[first_layer_bed_temperature] ; wait for bed temp\nM109 S[first_layer_temperature] ; wait for extruder temp\nG28 W ; home all without mesh bed level\nG80 ; mesh bed leveling\n\nG21 ; set units to millimeters\n\n;go outside print area\nG1 Y-3.0 F1000.0\nG1 Z0.4 F1000.0\n; select extruder\nTc\n; purge line\nG1 X55.0 F2000.0\nG1 Z0.3 F1000.0\nG92 E0.0\nG1 X240.0 E25.0 F2200.0\nG1 Y-2.0 F1000.0\nG1 X55.0 E25 F1400.0\nG1 Z0.20 F1000.0\nG1 X5.0 E4.0 F1000.0\nG92 E0.0\n
end_gcode = G1 X0 Y210 F7200\nG1 E2 F5000\nG1 E2 F5500\nG1 E2 F6000\nG1 E-15.0000 F5800\nG1 E-20.0000 F5500\nG1 E10.0000 F3000\nG1 E-10.0000 F3100\nG1 E10.0000 F3150\nG1 E-10.0000 F3250\nG1 E10.0000 F3300\n\nM702 C\n\nG4 ; wait\nM104 S0 ; turn off temperature\nM140 S0 ; turn off heatbed\nM107 ; turn off fan\nG1 X0 Y200 F3000 ; home X axis\nM84 ; disable motors

[printer:Original Prusa i3 MK2.5S MMU2S Single 0.6 nozzle]
inherits = Original Prusa i3 MK2.5S MMU2S Single
printer_notes = Don't remove the following keywords! These keywords are used in the "compatible printer" condition of the print and filament profiles to link the particular print and filament profiles to this printer profile.\nPRINTER_VENDOR_PRUSA3D\nPRINTER_MODEL_MK2\n
max_layer_height = 0.35
min_layer_height = 0.1
nozzle_diameter = 0.6
printer_variant = 0.6
default_print_profile = 0.20mm NORMAL 0.6 nozzle

[printer:Original Prusa i3 MK2.5S MMU2S Single 0.25 nozzle]
inherits = Original Prusa i3 MK2.5S MMU2S Single
printer_notes = Don't remove the following keywords! These keywords are used in the "compatible printer" condition of the print and filament profiles to link the particular print and filament profiles to this printer profile.\nPRINTER_VENDOR_PRUSA3D\nPRINTER_MODEL_MK2\n
max_layer_height = 0.15
min_layer_height = 0.05
nozzle_diameter = 0.25
printer_variant = 0.25
default_print_profile = 0.10mm DETAIL 0.25 nozzle
start_gcode = M115 U3.7.1 ; tell printer latest fw version\nG90 ; use absolute coordinates\nM83 ; extruder relative mode\nM104 S[first_layer_temperature] ; set extruder temp\nM140 S[first_layer_bed_temperature] ; set bed temp\nTx\nM190 S[first_layer_bed_temperature] ; wait for bed temp\nM109 S[first_layer_temperature] ; wait for extruder temp\nG28 W ; home all without mesh bed level\nG80 ; mesh bed leveling\n\nG21 ; set units to millimeters\n\n;go outside print area\nG1 Y-3.0 F1000.0\nG1 Z0.4 F1000.0\n; select extruder\nTc\n; purge line\nG1 X55.0 F2000.0\nG1 Z0.3 F1000.0\nG92 E0.0\nG1 X240.0 E25.0 F1400.0\nG1 Y-2.0 F1000.0\nG1 X55.0 E25 F1400.0\nG1 Z0.20 F1000.0\nG1 X5.0 E4.0 F1000.0\nG92 E0.0\n

[printer:Original Prusa i3 MK2.5S MMU2S]
inherits = Original Prusa i3 MK2.5; *mm2s*
printer_model = MK2.5SMMU2S
max_print_height = 200
remaining_times = 1
silent_mode = 0
retract_lift_below = 199
machine_max_acceleration_e = 10000
machine_max_acceleration_extruding = 2000
machine_max_acceleration_retracting = 1500
machine_max_acceleration_x = 9000
machine_max_acceleration_y = 9000
machine_max_acceleration_z = 500
machine_max_feedrate_e = 120
machine_max_feedrate_x = 500
machine_max_feedrate_y = 500
machine_max_feedrate_z = 12
machine_max_jerk_e = 2.5
machine_max_jerk_x = 10
machine_max_jerk_y = 10
machine_max_jerk_z = 0.2
machine_min_extruding_rate = 0
machine_min_travel_rate = 0
default_print_profile = 0.15mm OPTIMAL MK2.5
printer_notes = Don't remove the following keywords! These keywords are used in the "compatible printer" condition of the print and filament profiles to link the particular print and filament profiles to this printer profile.\nPRINTER_VENDOR_PRUSA3D\nPRINTER_MODEL_MK2.5\n
single_extruder_multi_material = 1
# The 5x nozzle diameter defines the number of extruders. Other extruder parameters
# (for example the retract values) are duplicaed from the first value, so they do not need 
# to be defined explicitely.
nozzle_diameter = 0.4,0.4,0.4,0.4,0.4
extruder_colour = #FF8000;#DB5182;#00FFFF;#FF4F4F;#9FFF9F
start_gcode = M115 U3.7.1 ; tell printer latest fw version\nG90 ; use absolute coordinates\nM83 ; extruder relative mode\nM104 S[first_layer_temperature] ; set extruder temp\nM140 S[first_layer_bed_temperature] ; set bed temp\nM190 S[first_layer_bed_temperature] ; wait for bed temp\nM109 S[first_layer_temperature] ; wait for extruder temp\nG28 W ; home all without mesh bed level\nG80 ; mesh bed leveling\nG21 ; set units to millimeters\n\n; Send the filament type to the MMU2.0 unit.\n; E stands for extruder number, F stands for filament type (0: default; 1:flex; 2: PVA)\nM403 E0 F{"" + ((filament_type[0]=="FLEX") ? 1 : ((filament_type[0]=="PVA") ? 2 : 0))}\nM403 E1 F{"" + ((filament_type[1]=="FLEX") ? 1 : ((filament_type[1]=="PVA") ? 2 : 0))}\nM403 E2 F{"" + ((filament_type[2]=="FLEX") ? 1 : ((filament_type[2]=="PVA") ? 2 : 0))}\nM403 E3 F{"" + ((filament_type[3]=="FLEX") ? 1 : ((filament_type[3]=="PVA") ? 2 : 0))}\nM403 E4 F{"" + ((filament_type[4]=="FLEX") ? 1 : ((filament_type[4]=="PVA") ? 2 : 0))}\n\n{if not has_single_extruder_multi_material_priming}\n;go outside print area\nG1 Y-3.0 F1000.0\nG1 Z0.4 F1000.0\n; select extruder\nT[initial_tool]\n; initial load\nG1 X55.0 E29.0 F1073.0\nG1 X5.0 E29.0 F1800.0\nG1 X55.0 E8.0 F2000.0\nG1 Z0.3 F1000.0\nG92 E0.0\nG1 X240.0 E25.0 F2200.0\nG1 Y-2.0 F1000.0\nG1 X55.0 E25 F1400.0\nG1 Z0.20 F1000.0\nG1 X5.0 E4.0 F1000.0\nG92 E0.0\n{endif}\nG92 E0.0\n
end_gcode = {if has_wipe_tower}\nG1 E-15.0000 F3000\n{else}\nG1 X0 Y210 F7200\nG1 E2 F5000\nG1 E2 F5500\nG1 E2 F6000\nG1 E-15.0000 F5800\nG1 E-20.0000 F5500\nG1 E10.0000 F3000\nG1 E-10.0000 F3100\nG1 E10.0000 F3150\nG1 E-10.0000 F3250\nG1 E10.0000 F3300\n{endif}\n\n; Unload filament\nM702 C\n\nG4 ; wait\nM104 S0 ; turn off temperature\nM140 S0 ; turn off heatbed\nM107 ; turn off fan\n; Lift print head a bit\n{if layer_z < max_print_height}G1 Z{z_offset+min(layer_z+30, max_print_height)}{endif} ; Move print head up\nG1 X0 Y200 F3000 ; home X axis\nM84 ; disable motors\n


# XXXXXXXXXXXXXXXXX
# XXX--- MK3 ---XXX
# XXXXXXXXXXXXXXXXX

[printer:Original Prusa i3 MK3]
inherits = *common*
end_gcode = G4 ; wait\nM221 S100\nM104 S0 ; turn off temperature\nM140 S0 ; turn off heatbed\nM107 ; turn off fan\n{if layer_z < max_print_height}G1 Z{z_offset+min(layer_z+30, max_print_height)}{endif} ; Move print head up\nG1 X0 Y200 F3000 ; home X axis\nM84 ; disable motors
machine_max_acceleration_e = 5000,5000
machine_max_acceleration_extruding = 1250,1250
machine_max_acceleration_retracting = 1250,1250
machine_max_acceleration_x = 1000,960
machine_max_acceleration_y = 1000,960
machine_max_acceleration_z = 1000,1000
machine_max_feedrate_e = 120,120
machine_max_feedrate_x = 200,100
machine_max_feedrate_y = 200,100
machine_max_feedrate_z = 12,12
machine_max_jerk_e = 1.5,1.5
machine_max_jerk_x = 8,8
machine_max_jerk_y = 8,8
machine_max_jerk_z = 0.4,0.4
machine_min_extruding_rate = 0,0
machine_min_travel_rate = 0,0
silent_mode = 1
remaining_times = 1
printer_notes = Don't remove the following keywords! These keywords are used in the "compatible printer" condition of the print and filament profiles to link the particular print and filament profiles to this printer profile.\nPRINTER_VENDOR_PRUSA3D\nPRINTER_MODEL_MK3\n
retract_lift_below = 209
max_print_height = 210
start_gcode = M115 U3.7.1 ; tell printer latest fw version\nG90 ; use absolute coordinates\nM83 ; extruder relative mode\nM104 S[first_layer_temperature] ; set extruder temp\nM140 S[first_layer_bed_temperature] ; set bed temp\nM190 S[first_layer_bed_temperature] ; wait for bed temp\nM109 S[first_layer_temperature] ; wait for extruder temp\nG28 W ; home all without mesh bed level\nG80 ; mesh bed leveling\nG1 Y-3.0 F1000.0 ; go outside print area\nG92 E0.0\nG1 X60.0 E9.0 F1000.0 ; intro line\nG1 X100.0 E12.5 F1000.0 ; intro line\nG92 E0.0\nM221 S{if layer_height<0.075}100{else}95{endif}
printer_model = MK3
default_print_profile = 0.15mm QUALITY MK3

[printer:Original Prusa i3 MK3 0.25 nozzle]
inherits = Original Prusa i3 MK3
nozzle_diameter = 0.25
max_layer_height = 0.15
min_layer_height = 0.05
printer_variant = 0.25
start_gcode = M115 U3.7.1 ; tell printer latest fw version\nG90 ; use absolute coordinates\nM83 ; extruder relative mode\nM104 S[first_layer_temperature] ; set extruder temp\nM140 S[first_layer_bed_temperature] ; set bed temp\nM190 S[first_layer_bed_temperature] ; wait for bed temp\nM109 S[first_layer_temperature] ; wait for extruder temp\nG28 W ; home all without mesh bed level\nG80 ; mesh bed leveling\nG1 Y-3.0 F1000.0 ; go outside print area\nG92 E0.0\nG1 X60.0 E8.0 F700.0 ; intro line\nG1 X100.0 E12.5 F700.0 ; intro line\nG92 E0.0\nM221 S{if layer_height<0.075}100{else}95{endif}
default_print_profile = 0.10mm DETAIL 0.25 nozzle MK3

[printer:Original Prusa i3 MK3 0.6 nozzle]
inherits = Original Prusa i3 MK3
nozzle_diameter = 0.6
max_layer_height = 0.40
min_layer_height = 0.15
printer_variant = 0.6
default_print_profile = 0.30mm QUALITY 0.6 nozzle MK3

[printer:Original Prusa i3 MK3S]
inherits = Original Prusa i3 MK3
printer_model = MK3S
start_gcode = M115 U3.7.1 ; tell printer latest fw version\nG90 ; use absolute coordinates\nM83 ; extruder relative mode\nM104 S[first_layer_temperature] ; set extruder temp\nM140 S[first_layer_bed_temperature] ; set bed temp\nM190 S[first_layer_bed_temperature] ; wait for bed temp\nM109 S[first_layer_temperature] ; wait for extruder temp\nG28 W ; home all without mesh bed level\nG80 ; mesh bed leveling\nG1 Y-3.0 F1000.0 ; go outside print area\nG92 E0.0\nG1 X60.0 E9.0 F1000.0 ; intro line\nG1 X100.0 E12.5 F1000.0 ; intro line\nG92 E0.0\nM221 S{if layer_height<0.075}100{else}95{endif}

[printer:Original Prusa i3 MK3S 0.25 nozzle]
inherits = Original Prusa i3 MK3 0.25 nozzle
printer_model = MK3S
start_gcode = M115 U3.7.1 ; tell printer latest fw version\nG90 ; use absolute coordinates\nM83 ; extruder relative mode\nM104 S[first_layer_temperature] ; set extruder temp\nM140 S[first_layer_bed_temperature] ; set bed temp\nM190 S[first_layer_bed_temperature] ; wait for bed temp\nM109 S[first_layer_temperature] ; wait for extruder temp\nG28 W ; home all without mesh bed level\nG80 ; mesh bed leveling\nG1 Y-3.0 F1000.0 ; go outside print area\nG92 E0.0\nG1 X60.0 E8.0 F700.0 ; intro line\nG1 X100.0 E12.5 F700.0 ; intro line\nG92 E0.0\nM221 S{if layer_height<0.075}100{else}95{endif}

[printer:Original Prusa i3 MK3S 0.6 nozzle]
inherits = Original Prusa i3 MK3 0.6 nozzle
printer_model = MK3S
start_gcode = M115 U3.7.1 ; tell printer latest fw version\nG90 ; use absolute coordinates\nM83 ; extruder relative mode\nM104 S[first_layer_temperature] ; set extruder temp\nM140 S[first_layer_bed_temperature] ; set bed temp\nM190 S[first_layer_bed_temperature] ; wait for bed temp\nM109 S[first_layer_temperature] ; wait for extruder temp\nG28 W ; home all without mesh bed level\nG80 ; mesh bed leveling\nG1 Y-3.0 F1000.0 ; go outside print area\nG92 E0.0\nG1 X60.0 E9.0 F1000.0 ; intro line\nG1 X100.0 E12.5 F1000.0 ; intro line\nG92 E0.0\nM221 S{if layer_height<0.075}100{else}95{endif}

[printer:*mm2*]
inherits = Original Prusa i3 MK3
single_extruder_multi_material = 1
cooling_tube_length = 10
cooling_tube_retraction = 30
parking_pos_retraction = 85
retract_length_toolchange = 3
extra_loading_move = -13
printer_model = MK3MMU2
default_print_profile = 0.15mm QUALITY MK3
default_filament_profile = Prusament PLA MMU2

[printer:*mm2s*]
inherits = Original Prusa i3 MK3
single_extruder_multi_material = 1
cooling_tube_length = 20
cooling_tube_retraction = 40
parking_pos_retraction = 85
retract_length_toolchange = 3
extra_loading_move = -25
printer_model = MK3SMMU2S
default_print_profile = 0.15mm QUALITY MK3
default_filament_profile = Prusament PLA MMU2

[printer:Original Prusa i3 MK3 MMU2 Single]
inherits = *mm2*
single_extruder_multi_material = 0
default_filament_profile = Prusament PLA
start_gcode = M115 U3.7.1 ; tell printer latest fw version\nG90 ; use absolute coordinates\nM83 ; extruder relative mode\nM104 S[first_layer_temperature] ; set extruder temp\nM140 S[first_layer_bed_temperature] ; set bed temp\nTx\nM190 S[first_layer_bed_temperature] ; wait for bed temp\nM109 S[first_layer_temperature] ; wait for extruder temp\nG28 W ; home all without mesh bed level\nG80 ; mesh bed leveling\n\nG21 ; set units to millimeters\n\n;go outside print area\nG1 Y-3.0 F1000.0\nG1 Z0.4 F1000.0\n; select extruder\nTc\n; purge line\nG1 X55.0 E8.0 F2000.0\nG1 Z0.3 F1000.0\nG92 E0.0\nG1 X240.0 E25.0 F2200.0\nG1 Y-2.0 F1000.0\nG1 X55.0 E25 F1400.0\nG1 Z0.20 F1000.0\nG1 X5.0 E4.0 F1000.0\n\nM221 S{if layer_height<0.075}100{else}95{endif}\nG92 E0.0\n
end_gcode = G1 X0 Y210 F7200\nG1 E2 F5000\nG1 E2 F5500\nG1 E2 F6000\nG1 E-15.0000 F5800\nG1 E-20.0000 F5500\nG1 E10.0000 F3000\nG1 E-10.0000 F3100\nG1 E10.0000 F3150\nG1 E-10.0000 F3250\nG1 E10.0000 F3300\n\nM702 C\n\nG4 ; wait\nM104 S0 ; turn off temperature\nM140 S0 ; turn off heatbed\nM107 ; turn off fan\nG1 X0 Y200 F3000 ; home X axis\nM84 ; disable motors

[printer:Original Prusa i3 MK3 MMU2 Single 0.6 nozzle]
inherits = Original Prusa i3 MK3 MMU2 Single
single_extruder_multi_material = 0
nozzle_diameter = 0.6
max_layer_height = 0.40
min_layer_height = 0.15
printer_variant = 0.6
default_print_profile = 0.30mm QUALITY 0.6 nozzle MK3

[printer:Original Prusa i3 MK3 MMU2 Single 0.25 nozzle]
inherits = Original Prusa i3 MK3 MMU2 Single
single_extruder_multi_material = 0
nozzle_diameter = 0.25
max_layer_height = 0.15
min_layer_height = 0.05
printer_variant = 0.25
start_gcode = M115 U3.7.1 ; tell printer latest fw version\nG90 ; use absolute coordinates\nM83 ; extruder relative mode\nM104 S[first_layer_temperature] ; set extruder temp\nM140 S[first_layer_bed_temperature] ; set bed temp\nTx\nM190 S[first_layer_bed_temperature] ; wait for bed temp\nM109 S[first_layer_temperature] ; wait for extruder temp\nG28 W ; home all without mesh bed level\nG80 ; mesh bed leveling\n\nG21 ; set units to millimeters\n\n;go outside print area\nG1 Y-3.0 F1000.0\nG1 Z0.4 F1000.0\n; select extruder\nTc\n; purge line\nG1 X55.0 E8.0 F1000.0\nG1 Z0.3 F1000.0\nG92 E0.0\nG1 X240.0 E25.0 F1400.0\nG1 Y-2.0 F1000.0\nG1 X55.0 E25 F1400.0\nG1 Z0.20 F1000.0\nG1 X5.0 E4.0 F1000.0\n\nM221 S{if layer_height<0.075}100{else}95{endif}\nG92 E0.0\n
default_print_profile = 0.10mm DETAIL 0.25 nozzle MK3

[printer:Original Prusa i3 MK3 MMU2]
inherits = *mm2*
# The 5x nozzle diameter defines the number of extruders. Other extruder parameters
# (for example the retract values) are duplicaed from the first value, so they do not need 
# to be defined explicitely.
machine_max_acceleration_e = 8000,8000
nozzle_diameter = 0.4,0.4,0.4,0.4,0.4
extruder_colour = #FF8000;#DB5182;#00FFFF;#FF4F4F;#9FFF9F
start_gcode = M115 U3.7.1 ; tell printer latest fw version\nG90 ; use absolute coordinates\nM83 ; extruder relative mode\nM104 S[first_layer_temperature] ; set extruder temp\nM140 S[first_layer_bed_temperature] ; set bed temp\nM190 S[first_layer_bed_temperature] ; wait for bed temp\nM109 S[first_layer_temperature] ; wait for extruder temp\nG28 W ; home all without mesh bed level\nG80 ; mesh bed leveling\nG21 ; set units to millimeters\n\n; Send the filament type to the MMU2.0 unit.\n; E stands for extruder number, F stands for filament type (0: default; 1:flex; 2: PVA)\nM403 E0 F{"" + ((filament_type[0]=="FLEX") ? 1 : ((filament_type[0]=="PVA") ? 2 : 0))}\nM403 E1 F{"" + ((filament_type[1]=="FLEX") ? 1 : ((filament_type[1]=="PVA") ? 2 : 0))}\nM403 E2 F{"" + ((filament_type[2]=="FLEX") ? 1 : ((filament_type[2]=="PVA") ? 2 : 0))}\nM403 E3 F{"" + ((filament_type[3]=="FLEX") ? 1 : ((filament_type[3]=="PVA") ? 2 : 0))}\nM403 E4 F{"" + ((filament_type[4]=="FLEX") ? 1 : ((filament_type[4]=="PVA") ? 2 : 0))}\n\n{if not has_single_extruder_multi_material_priming}\n;go outside print area\nG1 Y-3.0 F1000.0\nG1 Z0.4 F1000.0\n; select extruder\nT[initial_tool]\n; initial load\nG1 X55.0 E32.0 F1073.0\nG1 X5.0 E32.0 F1800.0\nG1 X55.0 E8.0 F2000.0\nG1 Z0.3 F1000.0\nG92 E0.0\nG1 X240.0 E25.0 F2200.0\nG1 Y-2.0 F1000.0\nG1 X55.0 E25 F1400.0\nG1 Z0.20 F1000.0\nG1 X5.0 E4.0 F1000.0\nG92 E0.0\n{endif}\n\nM221 S{if layer_height<0.075}100{else}95{endif}\nG92 E0.0\n
end_gcode = {if has_wipe_tower}\nG1 E-15.0000 F3000\n{else}\nG1 X0 Y210 F7200\nG1 E2 F5000\nG1 E2 F5500\nG1 E2 F6000\nG1 E-15.0000 F5800\nG1 E-20.0000 F5500\nG1 E10.0000 F3000\nG1 E-10.0000 F3100\nG1 E10.0000 F3150\nG1 E-10.0000 F3250\nG1 E10.0000 F3300\n{endif}\n\n; Unload filament\nM702 C\n\nG4 ; wait\nM104 S0 ; turn off temperature\nM140 S0 ; turn off heatbed\nM107 ; turn off fan\n; Lift print head a bit\n{if layer_z < max_print_height}G1 Z{z_offset+min(layer_z+30, max_print_height)}{endif} ; Move print head up\nG1 X0 Y200 F3000 ; home X axis\nM84 ; disable motors\n

[printer:Original Prusa i3 MK3S MMU2S Single]
inherits = *mm2s*
single_extruder_multi_material = 0
default_filament_profile = Prusament PLA
start_gcode = M115 U3.7.1 ; tell printer latest fw version\nG90 ; use absolute coordinates\nM83 ; extruder relative mode\nM104 S[first_layer_temperature] ; set extruder temp\nM140 S[first_layer_bed_temperature] ; set bed temp\nTx\nM190 S[first_layer_bed_temperature] ; wait for bed temp\nM109 S[first_layer_temperature] ; wait for extruder temp\nG28 W ; home all without mesh bed level\nG80 ; mesh bed leveling\n\nG21 ; set units to millimeters\n\n;go outside print area\nG1 Y-3.0 F1000.0\nG1 Z0.4 F1000.0\n; select extruder\nTc\n; purge line\nG1 X55.0 F2000.0\nG1 Z0.3 F1000.0\nG92 E0.0\nG1 X240.0 E25.0 F2200.0\nG1 Y-2.0 F1000.0\nG1 X55.0 E25 F1400.0\nG1 Z0.20 F1000.0\nG1 X5.0 E4.0 F1000.0\n\nM221 S{if layer_height<0.075}100{else}95{endif}\nG92 E0.0\n
end_gcode = G1 X0 Y210 F7200\nG1 E2 F5000\nG1 E2 F5500\nG1 E2 F6000\nG1 E-15.0000 F5800\nG1 E-20.0000 F5500\nG1 E10.0000 F3000\nG1 E-10.0000 F3100\nG1 E10.0000 F3150\nG1 E-10.0000 F3250\nG1 E10.0000 F3300\n\nM702 C\n\nG4 ; wait\nM104 S0 ; turn off temperature\nM140 S0 ; turn off heatbed\nM107 ; turn off fan\nG1 X0 Y200 F3000 ; home X axis\nM84 ; disable motors

[printer:Original Prusa i3 MK3S MMU2S Single 0.6 nozzle]
inherits = Original Prusa i3 MK3S MMU2S Single
single_extruder_multi_material = 0
nozzle_diameter = 0.6
max_layer_height = 0.40
min_layer_height = 0.15
printer_variant = 0.6
default_print_profile = 0.30mm QUALITY 0.6 nozzle MK3

[printer:Original Prusa i3 MK3S MMU2S Single 0.25 nozzle]
inherits = Original Prusa i3 MK3S MMU2S Single
single_extruder_multi_material = 0
nozzle_diameter = 0.25
max_layer_height = 0.15
min_layer_height = 0.05
printer_variant = 0.25
start_gcode = M115 U3.7.1 ; tell printer latest fw version\nG90 ; use absolute coordinates\nM83 ; extruder relative mode\nM104 S[first_layer_temperature] ; set extruder temp\nM140 S[first_layer_bed_temperature] ; set bed temp\nTx\nM190 S[first_layer_bed_temperature] ; wait for bed temp\nM109 S[first_layer_temperature] ; wait for extruder temp\nG28 W ; home all without mesh bed level\nG80 ; mesh bed leveling\n\nG21 ; set units to millimeters\n\n;go outside print area\nG1 Y-3.0 F1000.0\nG1 Z0.4 F1000.0\n; select extruder\nTc\n; purge line\nG1 X55.0 F2000.0\nG1 Z0.3 F1000.0\nG92 E0.0\nG1 X240.0 E25.0 F1400.0\nG1 Y-2.0 F1000.0\nG1 X55.0 E25 F1400.0\nG1 Z0.20 F1000.0\nG1 X5.0 E4.0 F1000.0\n\nM221 S{if layer_height<0.075}100{else}95{endif}\nG92 E0.0\n
default_print_profile = 0.10mm DETAIL 0.25 nozzle MK3

[printer:Original Prusa i3 MK3S MMU2S]
inherits = *mm2s*
machine_max_acceleration_e = 8000,8000
nozzle_diameter = 0.4,0.4,0.4,0.4,0.4
extruder_colour = #FF8000;#DB5182;#00FFFF;#FF4F4F;#9FFF9F
start_gcode = M115 U3.7.1 ; tell printer latest fw version\nG90 ; use absolute coordinates\nM83 ; extruder relative mode\nM104 S[first_layer_temperature] ; set extruder temp\nM140 S[first_layer_bed_temperature] ; set bed temp\nM190 S[first_layer_bed_temperature] ; wait for bed temp\nM109 S[first_layer_temperature] ; wait for extruder temp\nG28 W ; home all without mesh bed level\nG80 ; mesh bed leveling\nG21 ; set units to millimeters\n\n; Send the filament type to the MMU2.0 unit.\n; E stands for extruder number, F stands for filament type (0: default; 1:flex; 2: PVA)\nM403 E0 F{"" + ((filament_type[0]=="FLEX") ? 1 : ((filament_type[0]=="PVA") ? 2 : 0))}\nM403 E1 F{"" + ((filament_type[1]=="FLEX") ? 1 : ((filament_type[1]=="PVA") ? 2 : 0))}\nM403 E2 F{"" + ((filament_type[2]=="FLEX") ? 1 : ((filament_type[2]=="PVA") ? 2 : 0))}\nM403 E3 F{"" + ((filament_type[3]=="FLEX") ? 1 : ((filament_type[3]=="PVA") ? 2 : 0))}\nM403 E4 F{"" + ((filament_type[4]=="FLEX") ? 1 : ((filament_type[4]=="PVA") ? 2 : 0))}\n\n{if not has_single_extruder_multi_material_priming}\n;go outside print area\nG1 Y-3.0 F1000.0\nG1 Z0.4 F1000.0\n; select extruder\nT[initial_tool]\n; initial load\nG1 X55.0 E29.0 F1073.0\nG1 X5.0 E29.0 F1800.0\nG1 X55.0 E8.0 F2000.0\nG1 Z0.3 F1000.0\nG92 E0.0\nG1 X240.0 E25.0 F2200.0\nG1 Y-2.0 F1000.0\nG1 X55.0 E25 F1400.0\nG1 Z0.20 F1000.0\nG1 X5.0 E4.0 F1000.0\nG92 E0.0\n{endif}\n\nM221 S{if layer_height<0.075}100{else}95{endif}\nG92 E0.0\n
end_gcode = {if has_wipe_tower}\nG1 E-15.0000 F3000\n{else}\nG1 X0 Y210 F7200\nG1 E2 F5000\nG1 E2 F5500\nG1 E2 F6000\nG1 E-15.0000 F5800\nG1 E-20.0000 F5500\nG1 E10.0000 F3000\nG1 E-10.0000 F3100\nG1 E10.0000 F3150\nG1 E-10.0000 F3250\nG1 E10.0000 F3300\n{endif}\n\n; Unload filament\nM702 C\n\nG4 ; wait\nM104 S0 ; turn off temperature\nM140 S0 ; turn off heatbed\nM107 ; turn off fan\n; Lift print head a bit\n{if layer_z < max_print_height}G1 Z{z_offset+min(layer_z+30, max_print_height)}{endif} ; Move print head up\nG1 X0 Y200 F3000 ; home X axis\nM84 ; disable motors\n

# 0.6 nozzle MMU printer profile - only for single mode for now

# [printer:Original Prusa i3 MK3S MMU2S 0.6 nozzle]
# inherits = Original Prusa i3 MK3S MMU2S
# nozzle_diameter = 0.6,0.6,0.6,0.6,0.6
# max_layer_height = 0.40
# min_layer_height = 0.15
# printer_variant = 0.6
# default_print_profile = 0.30mm QUALITY 0.6 nozzle MK3

[printer:Original Prusa SL1]
printer_technology = SLA
printer_model = SL1
printer_variant = default
default_sla_material_profile = Prusa Orange Tough 0.05
default_sla_print_profile = 0.05 Normal
bed_shape = 0.98x1.02,119.98x1.02,119.98x67.02,0.98x67.02
display_height = 68.04
display_orientation = portrait
display_pixels_x = 2560
display_pixels_y = 1440
display_width = 120.96
max_print_height = 150
printer_correction = 1,1,1
printer_notes = Don't remove the following keywords! These keywords are used in the "compatible printer" condition of the print and filament profiles to link the particular print and filament profiles to this printer profile.\nPRINTER_VENDOR_PRUSA3D\nPRINTER_MODEL_SL1\n

# The obsolete presets will be removed when upgrading from the legacy configuration structure (up to Slic3r 1.39.2) to 1.40.0 and newer.
[obsolete_presets]
print="0.05mm DETAIL 0.25 nozzle";"0.05mm DETAIL MK3";"0.05mm DETAIL";"0.20mm NORMAL MK3";"0.35mm FAST MK3";"print:0.15mm OPTIMAL MK3 MMU2";"print:0.20mm FAST MK3 MMU2"
filament="ColorFabb Brass Bronze 1.75mm";"ColorFabb HT 1.75mm";"ColorFabb nGen 1.75mm";"ColorFabb Woodfil 1.75mm";"ColorFabb XT 1.75mm";"ColorFabb XT-CF20 1.75mm";"E3D PC-ABS 1.75mm";"Fillamentum ABS 1.75mm";"Fillamentum ASA 1.75mm";"Generic ABS 1.75mm";"Generic PET 1.75mm";"Generic PLA 1.75mm";"Prusa ABS 1.75mm";"Prusa HIPS 1.75mm";"Prusa PET 1.75mm";"Prusa PLA 1.75mm";"Taulman Bridge 1.75mm";"Taulman T-Glase 1.75mm"
