ddr997/ZgrzewanieCNC/(commit log)

2021-02-12 Create Zgrzewanie CNC folii - Praca dyplomowa, Maciej Łukaszewicz.pdf
    Opisana budowa maszyny i konfiguracja Marlin
2021-02-12 Create Zgrzewanie CNC folii - Praca dyplomowa.pdf
    Opisana budowa + konfiguracja Marlin
